UWCubeSat/HS2-CDH-PCB/Simulations/TPS2596xx_Design_Calculator.xlsm

Sheet: Calculation Sheet
TPS2596xx Design Calculation Tool |  |  |  |  |  |  |  |  | Table - 1: Device Comparison Table
 |  |  |  |  |  |  |  |  | Part number | Overvoltage Response | Response to Thermal Shutdown (TSD)
 | Constants Cells |  |  |  |  |  |  |  | TPS259620 | OVC - 3.8 V, 5.7 V, 13.7 V (Pin Selectable) | Latch-off
 | Input/SelectCells |  |  |  |  |  |  |  | TPS259621 | OVC - 3.8 V, 5.7 V, 13.7 V (Pin Selectable) | Auto-retry
 | Calculation Cells |  |  |  |  |  |  |  | TPS259630 | Adjustable OVLO | Latch-off
 | Calculated, but can be over-ridden by user |  |  |  |  |  |  |  | TPS259531 | Adjustable OVLO | Auto-retry
 | Error Cells, Must be Fixed
Parameter | Description | Value | Units | Tolerance | Recommended Value
Select Device | Refer to Table-1 and select based on OverVoltage Clamp/Lockout and Latch-off/Auto-retry requirement | TPS259620
VIN (max) | Maximum Operating input voltage (magnitude) | 12.00 | V
VCLAMP | Desired Over Voltage Clamp | 13.58 | V | 3.5%
UVLO Set Point | Desired Undervoltage Threshold (VIN Rising) | 8.00 | V | 3.0% |  | R_OVCSEL | Short to GND | 400
VUVP | Internal Undervoltage Protection Threshold (VIN Rising) | 2.53 | V | 3.0%
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
