UWCubeSat/HS2-CDH-PCB/(list of files, drawings)

Other design files:
Simulations/Payload Camera Input Spice.ms14
Simulations/Payload Camera Output Spice.ms14
Simulations/Payload Camera Spice.ms14
