UWCubeSat/HS2-CDH-PCB/Payload PCB/hs2-payload-pcb/hs2-payload-pcb.kicad_pcb

## KiCad design Payload PCB/hs2-payload-pcb/hs2-payload-pcb.kicad_pcb (2026-11-13)

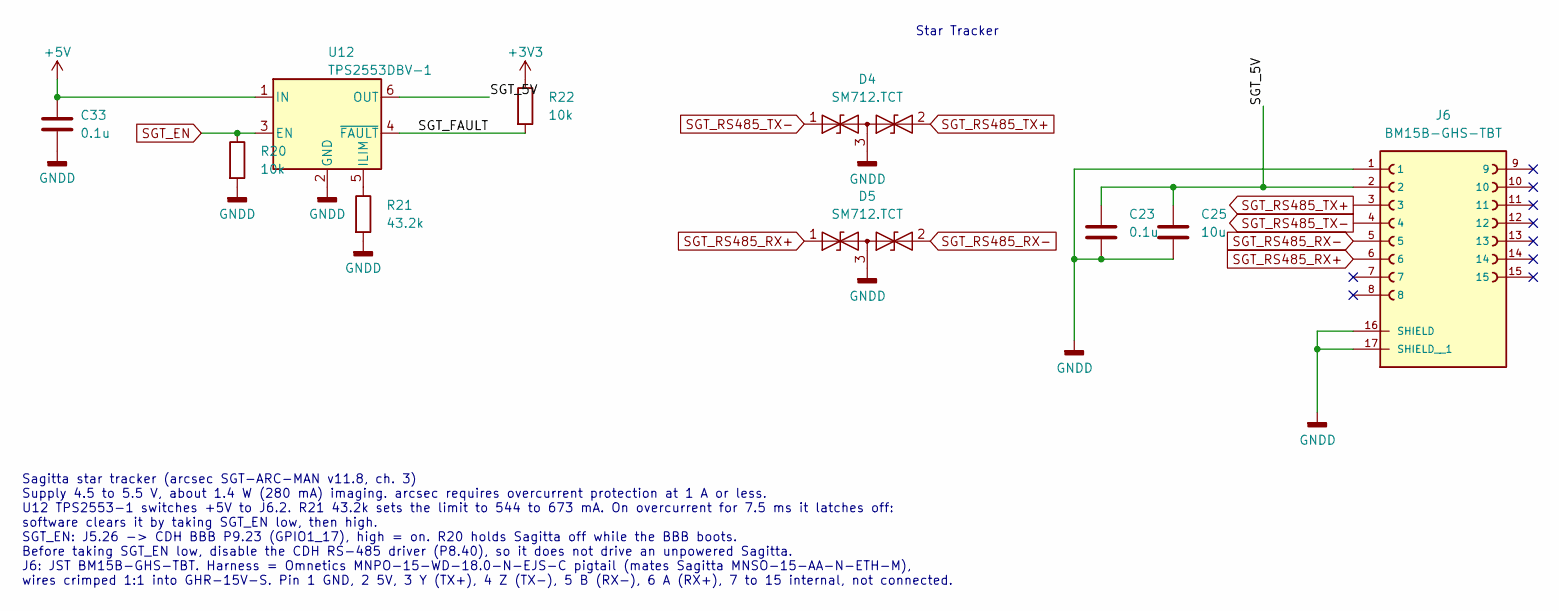
[picture p1: schematic Sagitta.kicad_sch, Star tracker (Sagitta)]

Parts:
C23, C33: 0.1u; C_0603_1608Metric
C25: 10u; C_0603_1608Metric
D4, D5: SM712.TCT; SOT-23; MPN SM712.TCT
J6: BM15B-GHS-TBT; BM15BGHSTBTLFSN; PARTREV B
R20, R22: 10k; R_0603_1608Metric
R21: 43.2k; R_0603_1608Metric
U12: TPS2553DBV-1; SOT-23-6; MPN TPS2553DBVR-1

Connections:
+3V3: R22.1; also elsewhere on the board
+5V: C33.1, U12.1 (IN); also elsewhere on the board
/Sagitta/SGT_5V: C23.1, C25.1, J6.2, U12.6 (OUT)
/Sagitta/SGT_FAULT: R22.2, U12.4 (~FAULT)
GNDD: C23.2, C25.2, C33.2, D4.3 (common), D5.3 (common), J6.1, J6.16 (SHIELD), J6.17 (SHIELD__1), R20.2, R21.2, U12.2 (GND); also elsewhere on the board
unnamed: R21.1, U12.5 (ILIM)
SGT_EN: R20.1, U12.3 (EN); also elsewhere on the board
SGT_RS485_RX+: D5.1 (A1), J6.6; also elsewhere on the board
SGT_RS485_RX-: D5.2 (A2), J6.5; also elsewhere on the board
SGT_RS485_TX+: D4.2 (A2), J6.3; also elsewhere on the board
SGT_RS485_TX-: D4.1 (A1), J6.4; also elsewhere on the board

Notes on the sheet:
Star Tracker
Sagitta star tracker (arcsec SGT-ARC-MAN v11.8, ch. 3) Supply 4.5 to 5.5 V, about 1.4 W (280 mA) imaging. arcsec requires overcurrent protection at 1 A or less. U12 TPS2553-1 switches +5V to J6.2. R21 43.2k sets the limit to 544 to 673 mA. On overcurrent for 7.5 ms it latches off: software clears i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

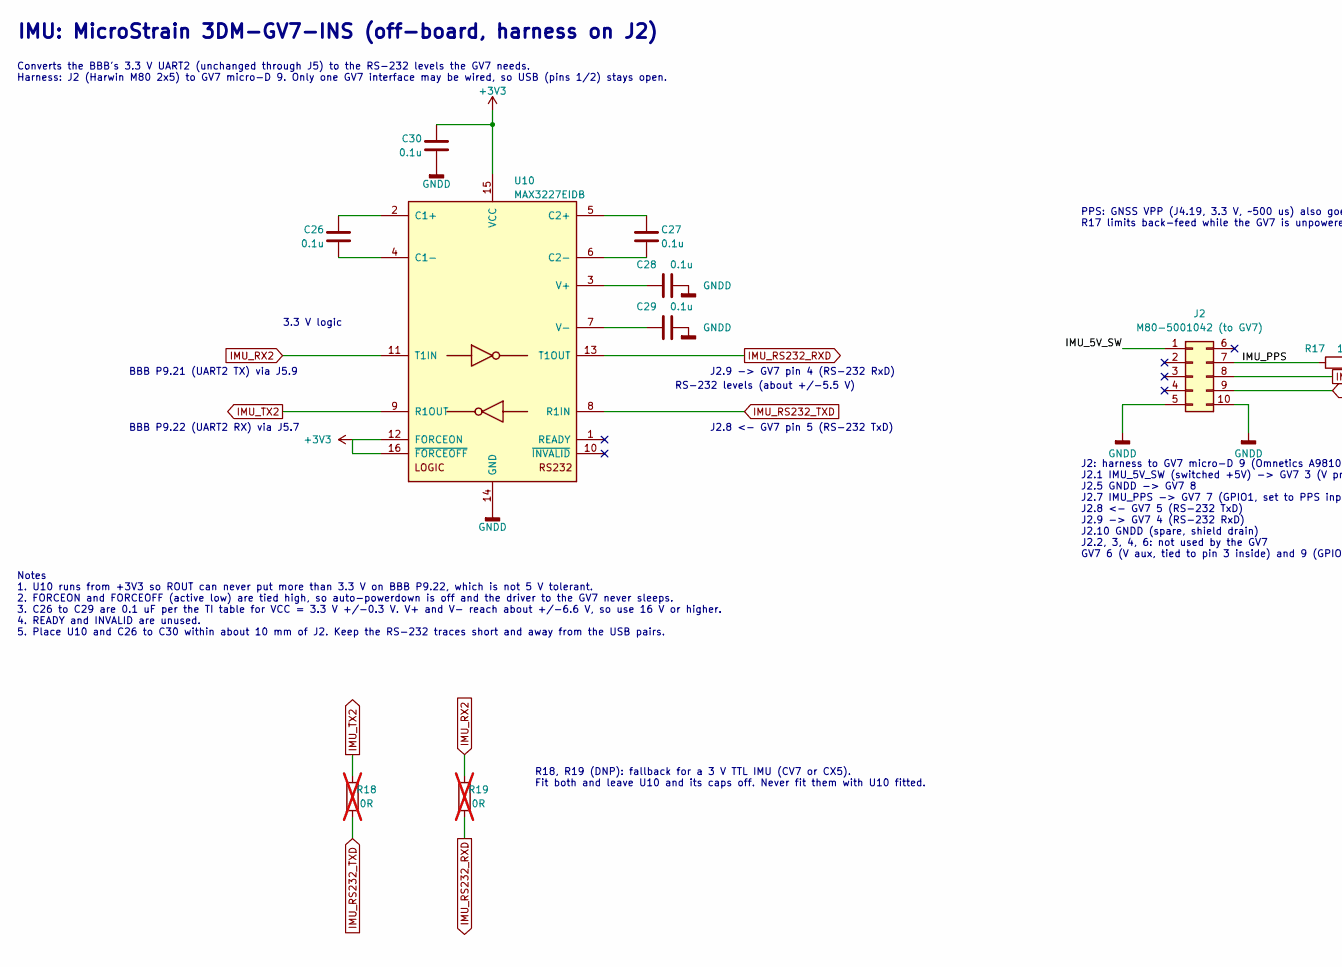
[picture p2: schematic IMU.kicad_sch, part in row 1, column 1]

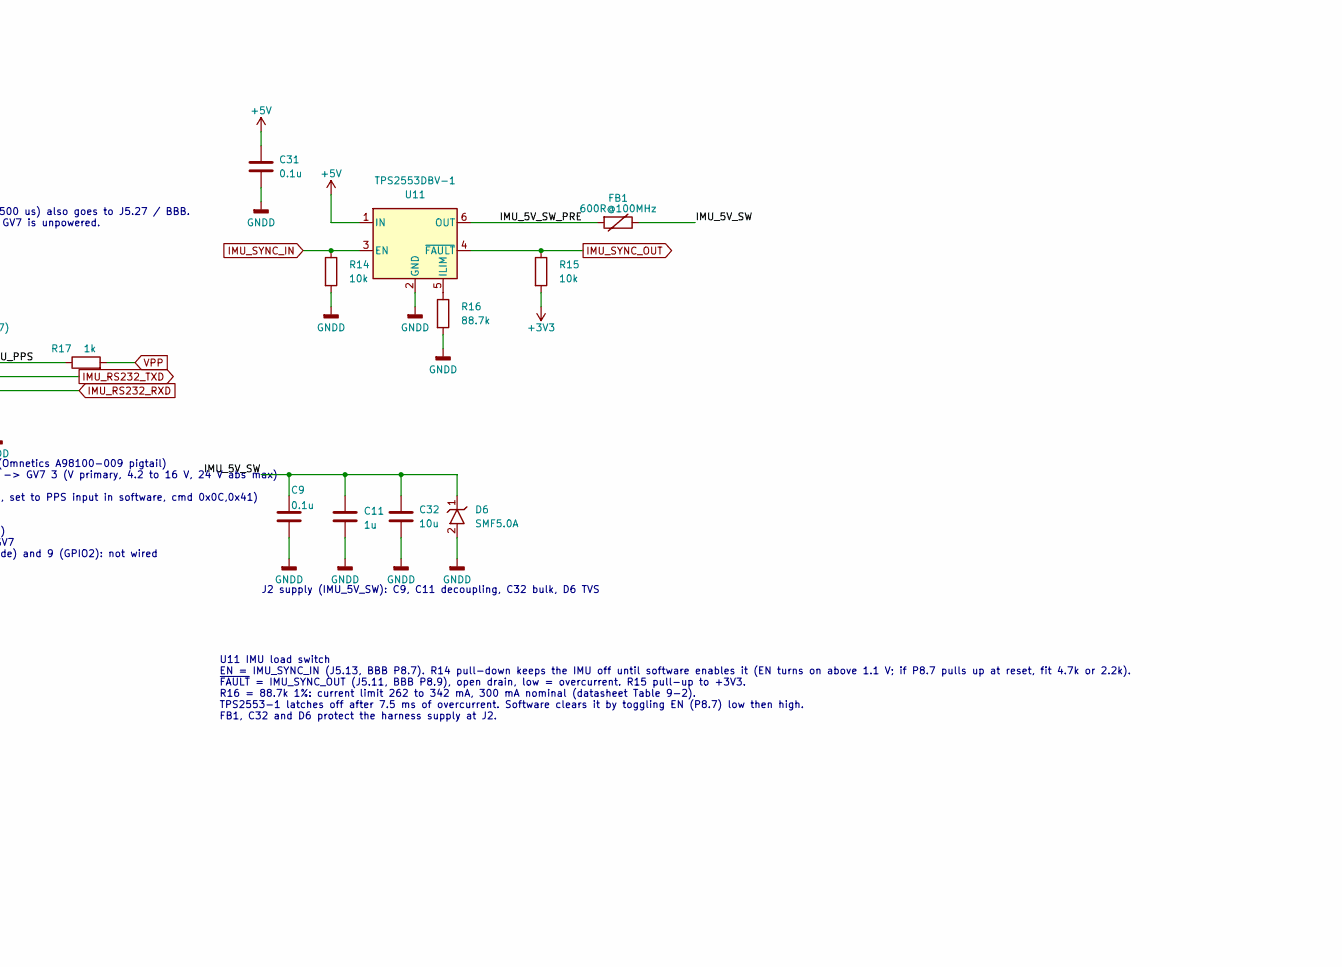
[picture p3: schematic IMU.kicad_sch, part in row 1, column 2]

Parts:
C9, C26, C27, C28, C29, C30, C31: 0.1u; C_0603_1608Metric
C11: 1u; C_0603_1608Metric
C32: 10u; C_0805_2012Metric
D6: SMF5.0A; D_SMF; MPN SMF5.0A
FB1: 600R@100MHz; L_0805_2012Metric
J2: M80-5001042 (to GV7); Harwin-M80-5001042-0-0-MFG
R14, R15: 10k; R_0603_1608Metric
R16: 88.7k; R_0603_1608Metric
R17: 1k; R_0603_1608Metric
R18, R19: 0R; R_0402_1005Metric; not fitted
U10: MAX3227EIDB; SSOP-16_5.3x6.2mm_P0.65mm; MPN MAX3227EIDBR
U11: TPS2553DBV-1; SOT-23-6; MPN TPS2553DBVR-1

Connections:
+3V3: C30.1, R15.2, U10.12 (FORCEON), U10.15 (VCC), U10.16 (~FORCEOFF); also elsewhere on the board
+5V: C31.1, U11.1 (IN); also elsewhere on the board
/IMU/IMU_5V_SW: C9.1, C11.1, C32.1, D6.1 (K), FB1.2, J2.1
/IMU/IMU_5V_SW_PRE: FB1.1, U11.6 (OUT)
/IMU/IMU_PPS: J2.7, R17.1
GNDD: C9.2, C11.2, C28.2, C29.2, C30.2, C31.2, C32.2, D6.2 (A), J2.5, J2.10, R14.2, R16.2, U10.14 (GND), U11.2 (GND); also elsewhere on the board
IMU_RS232_RXD: J2.9, R19.2, U10.13 (T1OUT)
IMU_RS232_TXD: J2.8, R18.2, U10.8 (R1IN)
IMU_RX2: R19.1, U10.11 (T1IN); also elsewhere on the board
IMU_SYNC_IN: R14.1, U11.3 (EN); also elsewhere on the board
IMU_SYNC_OUT: R15.1, U11.4 (~FAULT); also elsewhere on the board
IMU_TX2: R18.1, U10.9 (R1OUT); also elsewhere on the board
unnamed: C26.1, U10.2 (C1+)
unnamed: C26.2, U10.4 (C1-)
unnamed: C27.1, U10.5 (C2+)
unnamed: C27.2, U10.6 (C2-)
unnamed: C28.1, U10.3 (V+)
unnamed: C29.1, U10.7 (V-)
unnamed: R16.1, U11.5 (ILIM)
VPP: R17.2; also elsewhere on the board

Notes on the sheet:
BBB P9.22 (UART2 RX) via J5.7
U11 IMU load switch EN = IMU_SYNC_IN (J5.13, BBB P8.7). R14 pull-down keeps the IMU off until software enables it (EN turns on above 1.1 V; if P8.7 pulls up at reset, fit 4.7k or 2.2k). ~{FAULT} = IMU_SYNC_OUT (J5.11, BBB P8.9), open drain, low = overcurrent. R15 pull-up to +3V3. R16 = 88.7k 1%: cu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
3.3 V logic
PPS: GNSS VPP (J4.19, 3.3 V, ~500 us) also goes to J5.27 / BBB. R17 limits back-feed while the GV7 is unpowered.
IMU: MicroStrain 3DM-GV7-INS (off-board, harness on J2)
Converts the BBB's 3.3 V UART2 (unchanged through J5) to the RS-232 levels the GV7 needs. Harness: J2 (Harwin M80 2x5) to GV7 micro-D 9. Only one GV7 interface may be wired, so USB (pins 1/2) stays open.
J2.8 <- GV7 pin 5 (RS-232 TxD)
Notes 1. U10 runs from +3V3 so ROUT can never put more than 3.3 V on BBB P9.22, which is not 5 V tolerant. 2. FORCEON and FORCEOFF (active low) are tied high, so auto-powerdown is off and the driver to the GV7 never sleeps. 3. C26 to C29 are 0.1 uF per the TI table for VCC = 3.3 V +/-0.3 V. V+ and 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
RS-232 levels (about +/-5.5 V)
BBB P9.21 (UART2 TX) via J5.9
J2 supply (IMU_5V_SW): C9, C11 decoupling, C32 bulk, D6 TVS
J2: harness to GV7 micro-D 9 (Omnetics A98100-009 pigtail) J2.1 IMU_5V_SW (switched +5V) -> GV7 3 (V primary, 4.2 to 16 V, 24 V abs max) J2.5 GNDD -> GV7 8 J2.7 IMU_PPS -> GV7 7 (GPIO1, set to PPS input in software, cmd 0x0C,0x41) J2.8 <- GV7 5 (RS-232 TxD) J2.9 -> GV7 4 (RS-232 RxD) J2.10 GNDD (sp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
R18, R19 (DNP): fallback for a 3 V TTL IMU (CV7 or CX5). Fit both and leave U10 and its caps off. Never fit them with U10 fitted.
J2.9 -> GV7 pin 4 (RS-232 RxD)

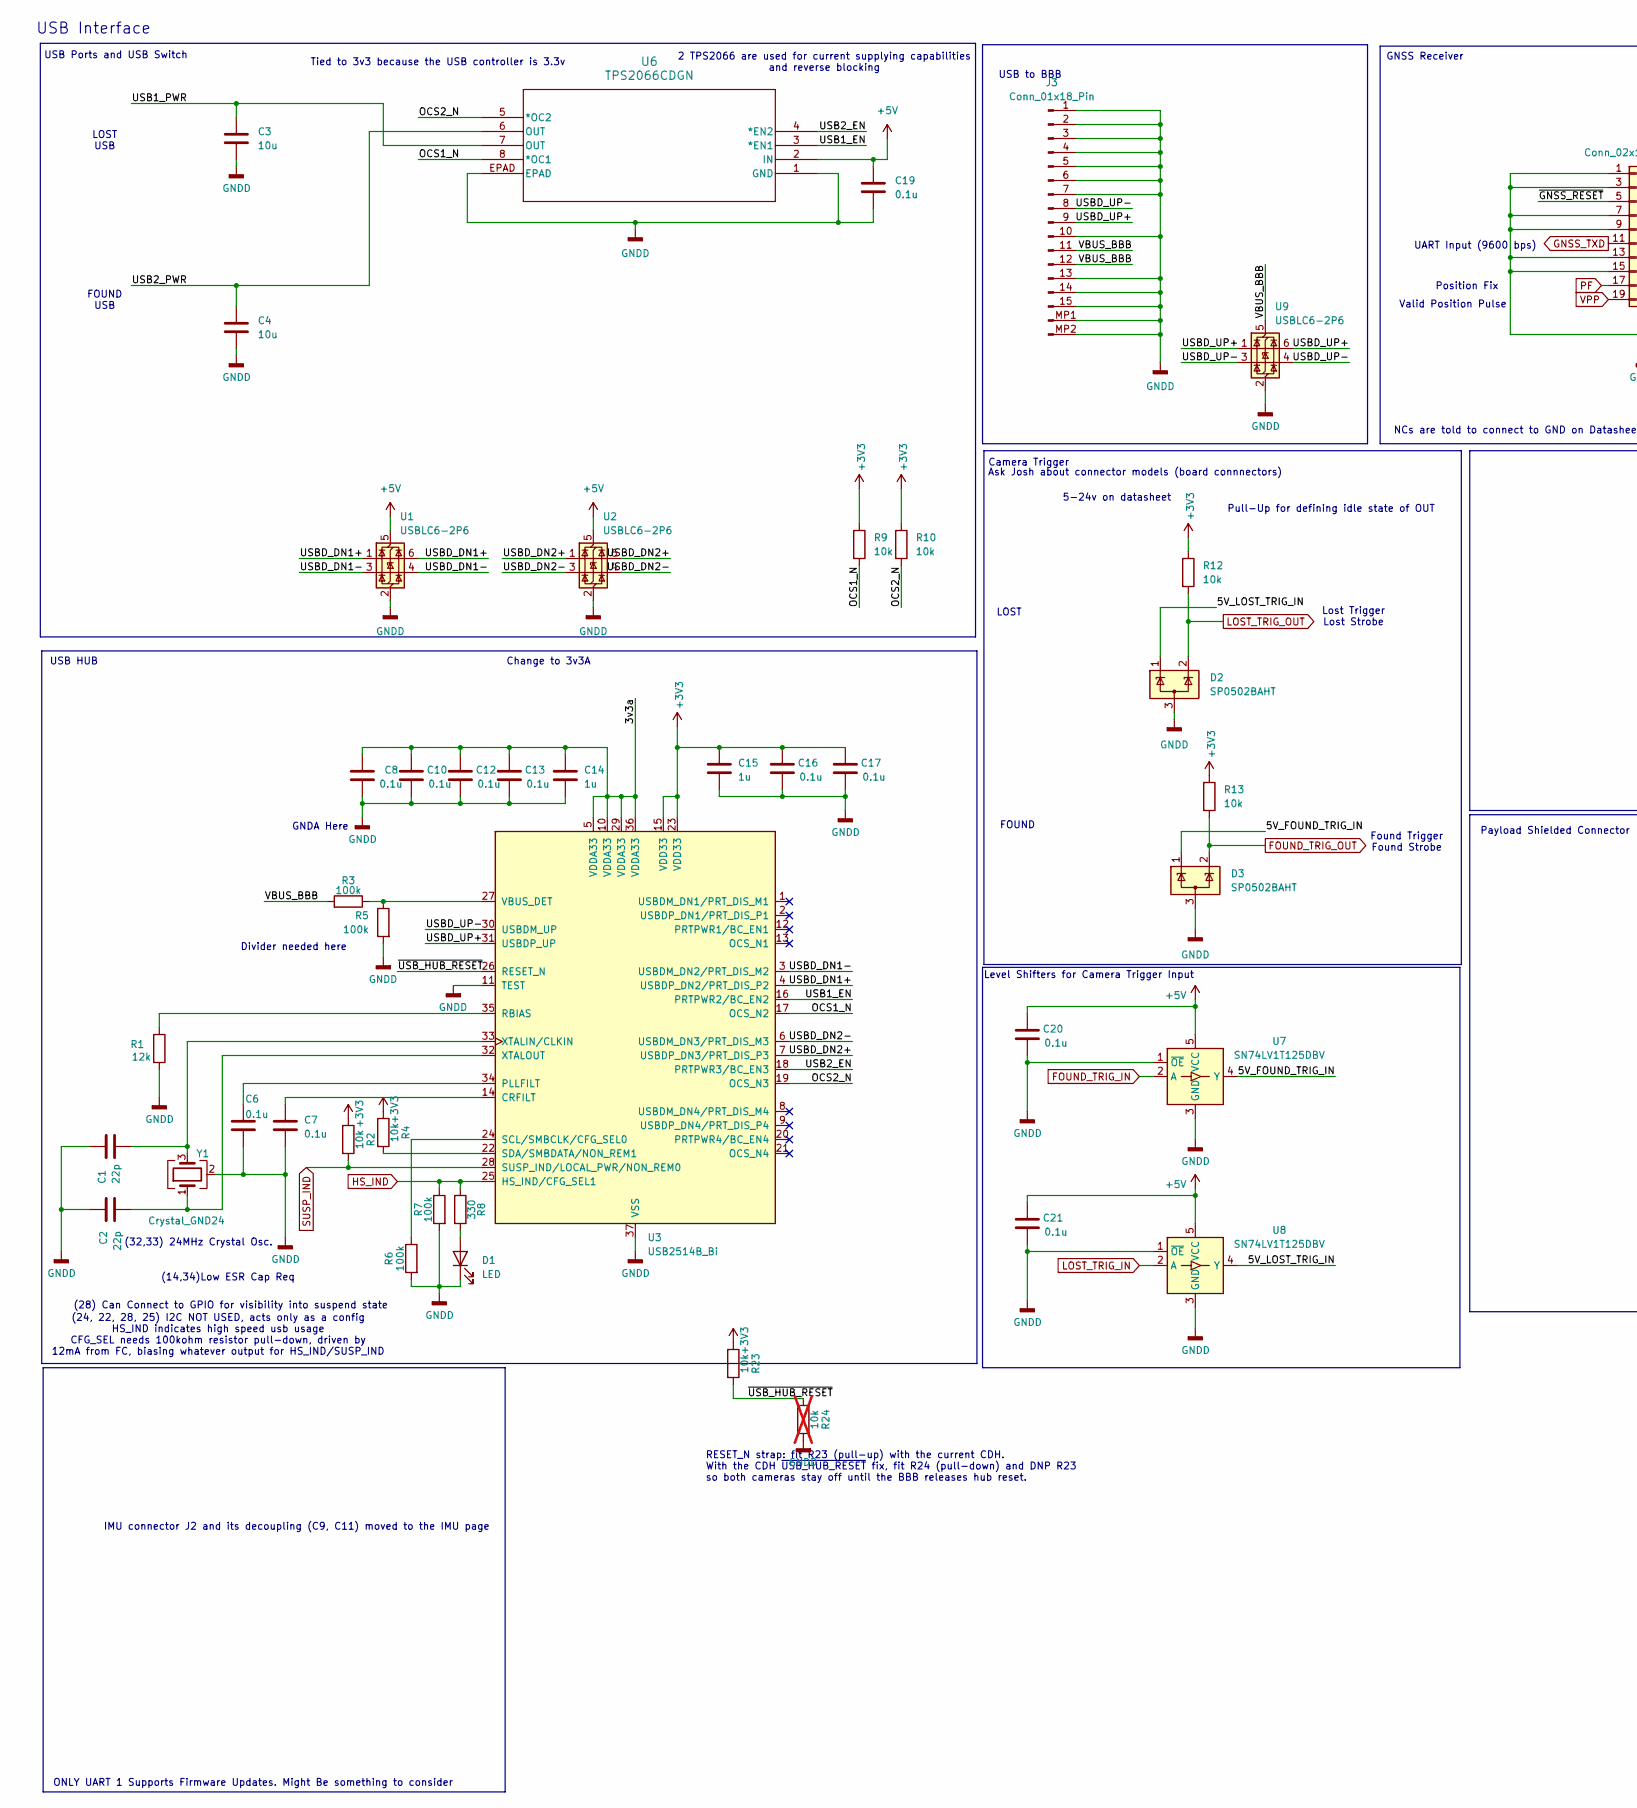
[picture p4: schematic Payload_USB.kicad_sch, part in row 1, column 1]

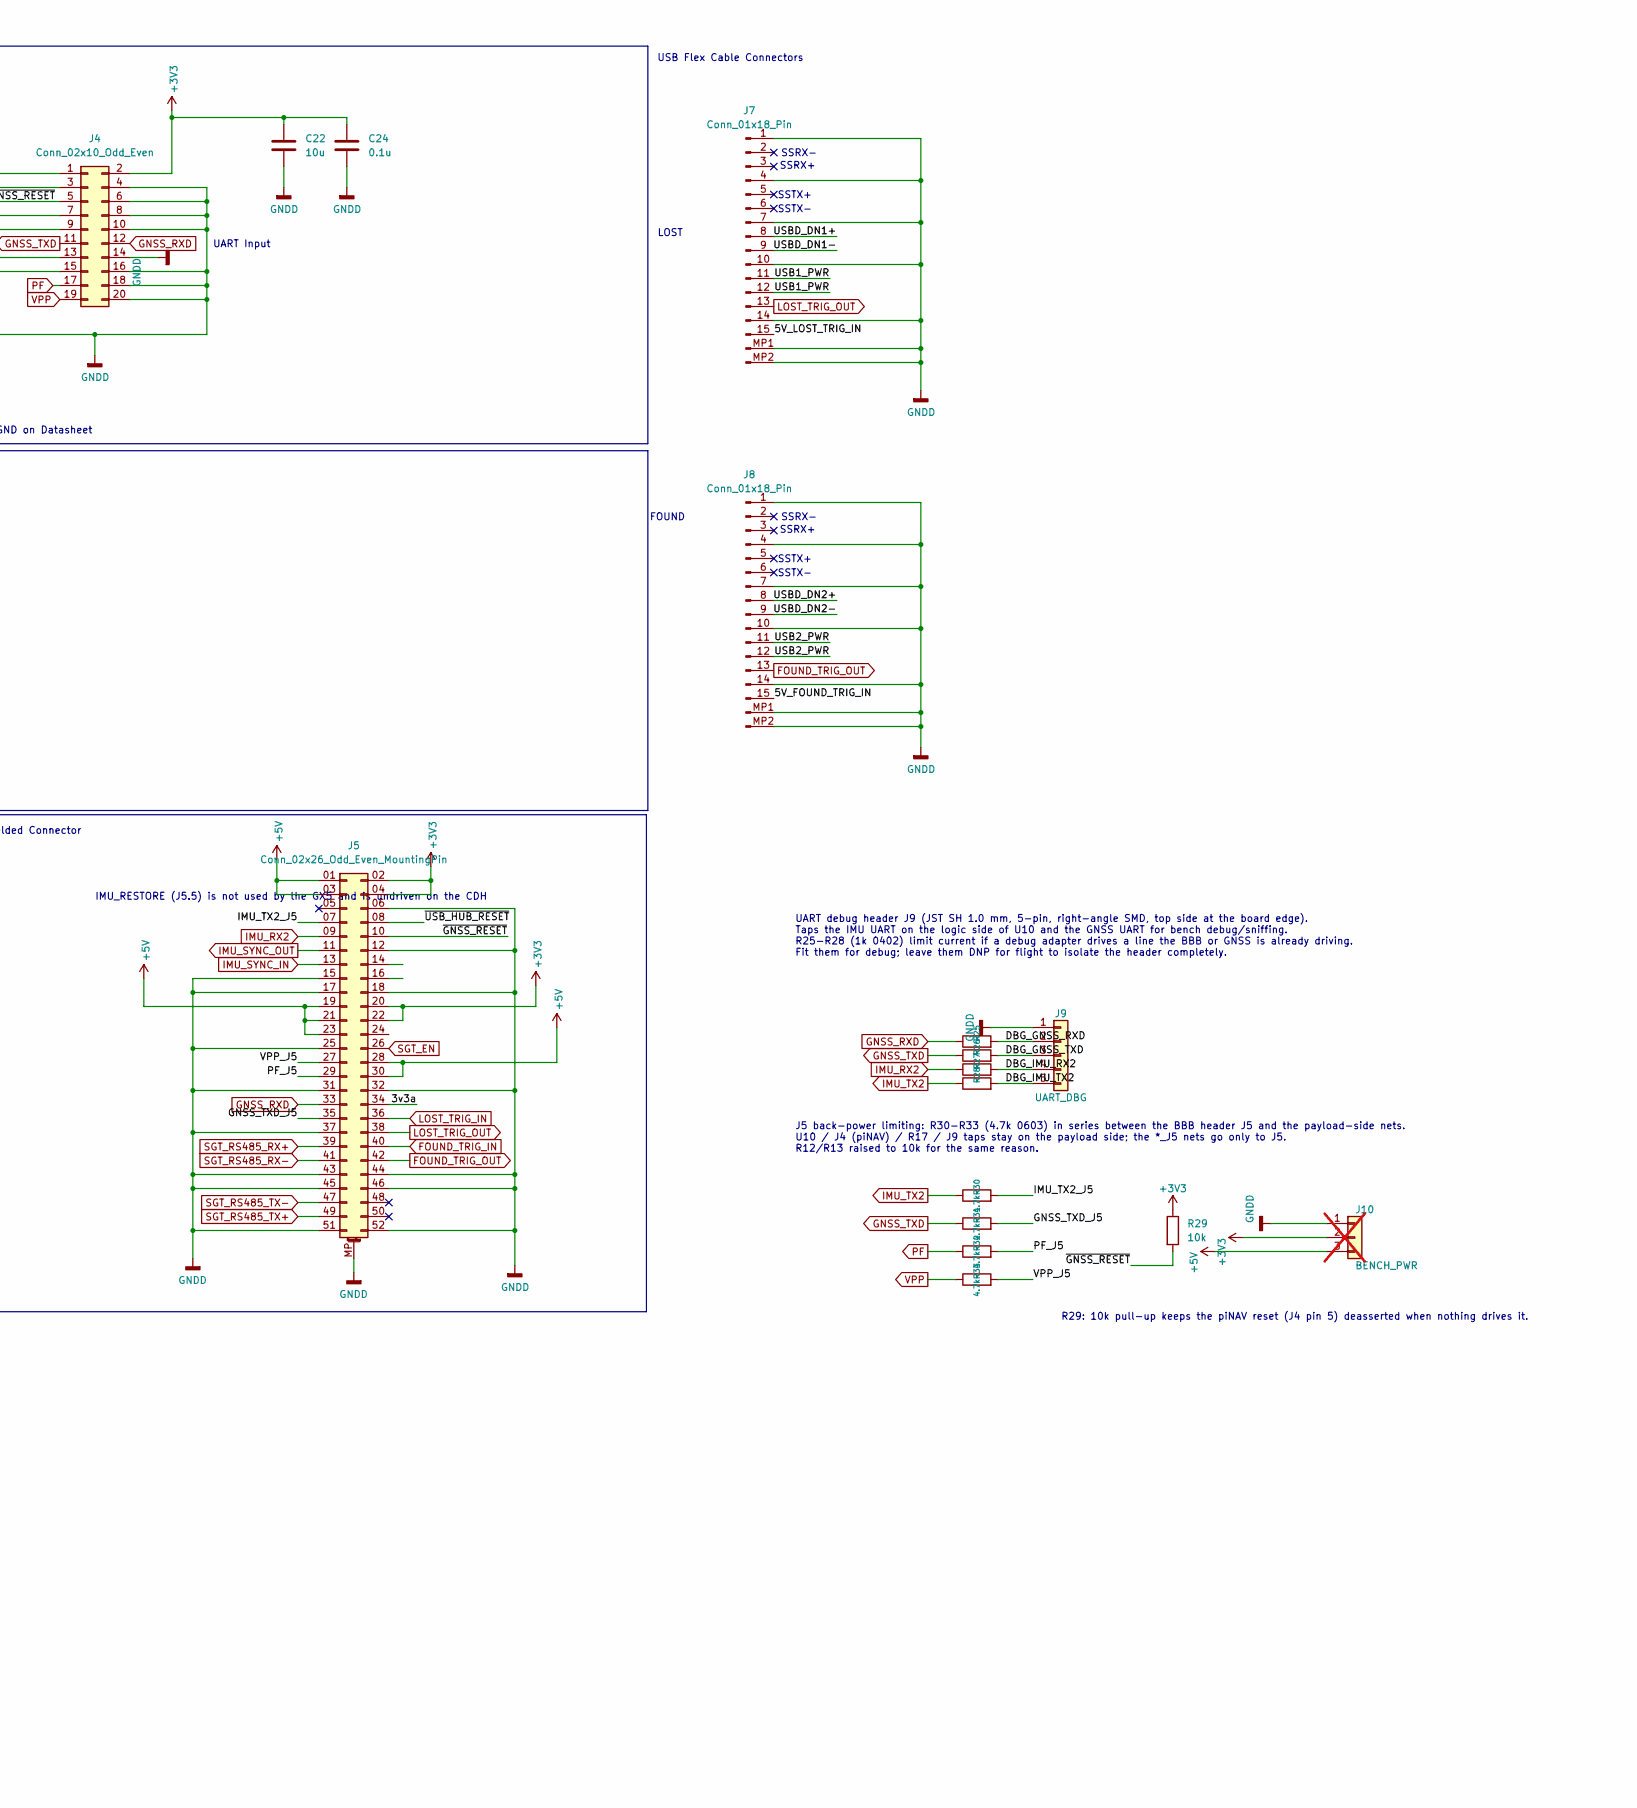
[picture p5: schematic Payload_USB.kicad_sch, part in row 1, column 2]

Parts:
C1, C2: 22p; C_0603_1608Metric
C3, C4, C22: 10u; C_0603_1608Metric
C6, C7, C8, C10, C12, C13, C16, C17, C19, C20, C21, C24: 0.1u; C_0603_1608Metric
C14, C15: 1u; C_0603_1608Metric
D1: LED; LED_0603_1608Metric
D2, D3: SP0502BAHT; SOT-23
J3, J7, J8: Conn_01x18_Pin; Molex 502231-1500
J4: Conn_02x10_Odd_Even; PinHeader_2x10_P2.00mm_Vertical
J5: Conn_02x26_Odd_Even_MountingPin; SAMTEC_ASP-129646-01
J9: UART_DBG; JST_SH_SM05B-SRSS-TB_1x05-1MP_P1.00mm_Horizontal
J10: BENCH_PWR; PinHeader_1x03_P2.54mm_Horizontal; not fitted
R1: 12k; R_0603_1608Metric
R2, R4, R9, R10, R12, R13, R23, R29: 10k; R_0603_1608Metric
R3, R5, R6, R7: 100k; R_0603_1608Metric
R8: 330; R_0603_1608Metric
R24: 10k; R_0603_1608Metric; not fitted
R25, R26, R27, R28: 1k; R_0603_1608Metric
R30, R31, R32, R33: 4.7k; R_0603_1608Metric
U1, U2, U9: USBLC6-2P6; SOT-666
U3: USB2514B_Bi; QFN-36-1EP_6x6mm_P0.5mm_EP3.7x3.7mm
U6: TPS2066CDGN; DGN8_1P89x1P57_TEX
U7, U8: SN74LV1T125DBV; SOT-23-5
Y1: Crystal_GND24; Crystal_SMD_Abracon_ABM8G-4Pin_3.2x2.5mm

Connections:
+3V3: C15.1, C16.1, C17.1, C22.1, C24.1, J4.2, J5.02 (Pin_2), J5.04 (Pin_4), J5.20, J5.22, J10.2, R2.1, R4.1, R9.1, R10.1, R12.1, R13.1, R23.1, R29.1, U3.15 (VDD33), U3.23 (VDD33); also elsewhere on the board
+5V: C19.1, C20.1, C21.1, J5.01 (Pin_1), J5.03 (Pin_3), J5.19, J5.21, J5.23, J5.28, J5.30, J10.3, U1.5 (VBUS), U2.5 (VBUS), U6.2 (IN), U7.5 (VCC), U8.5 (VCC); also elsewhere on the board
/Payload_USB/3v3a: C8.1, C10.1, C12.1, C13.1, C14.1, J5.34, U3.5 (VDDA33), U3.10 (VDDA33), U3.29 (VDDA33), U3.36 (VDDA33)
/Payload_USB/5V_FOUND_TRIG_IN: D3.1 (K), J8.15, U7.4 (Y)
/Payload_USB/5V_LOST_TRIG_IN: D2.1 (K), J7.15, U8.4 (Y)
/Payload_USB/DBG_GNSS_RXD: J9.2, R25.2
/Payload_USB/DBG_GNSS_TXD: J9.3, R26.2
/Payload_USB/DBG_IMU_RX2: J9.4, R27.2
/Payload_USB/DBG_IMU_TX2: J9.5, R28.2
/Payload_USB/GNSS_TXD_J5: J5.35, R31.2
/Payload_USB/IMU_TX2_J5: J5.07 (Pin_7), R30.2
/Payload_USB/OCS1_N: R9.2, U3.17 (OCS_N2), U6.8 (*OC1)
/Payload_USB/OCS2_N: R10.2, U3.19 (OCS_N3), U6.5 (*OC2)
/Payload_USB/PF_J5: J5.29, R32.2
/Payload_USB/USB1_EN: U3.16 (PRTPWR2/BC_EN2), U6.3 (*EN1)
/Payload_USB/USB1_PWR: C3.1, J7.11, J7.12, U6.7 (OUT)
/Payload_USB/USB2_EN: U3.18 (PRTPWR3/BC_EN3), U6.4 (*EN2)
/Payload_USB/USB2_PWR: C4.1, J8.11, J8.12, U6.6 (OUT)
/Payload_USB/USBD_DN1+: J7.8, U1.1 (I/O1), U1.6 (I/O1), U3.4 (USBDP_DN2/PRT_DIS_P2)
/Payload_USB/USBD_DN1-: J7.9, U1.3 (I/O2), U1.4 (I/O2), U3.3 (USBDM_DN2/PRT_DIS_M2)
/Payload_USB/USBD_DN2+: J8.8, U2.1 (I/O1), U2.6 (I/O1), U3.7 (USBDP_DN3/PRT_DIS_P3)
/Payload_USB/USBD_DN2-: J8.9, U2.3 (I/O2), U2.4 (I/O2), U3.6 (USBDM_DN3/PRT_DIS_M3)
/Payload_USB/USBD_UP+: J3.9, U3.31 (USBDP_UP), U9.1 (I/O1), U9.6 (I/O1)
/Payload_USB/USBD_UP-: J3.8, U3.30 (USBDM_UP), U9.3 (I/O2), U9.4 (I/O2)
/Payload_USB/VBUS_BBB: J3.11, J3.12, R3.2, U9.5 (VBUS)
/Payload_USB/VPP_J5: J5.27, R33.2
/Payload_USB/~GNSS_RESET: J4.5, J5.10, R29.2
/Payload_USB/~USB_HUB_RESET: J5.08 (Pin_8), R23.2, R24.1, U3.26 (RESET_N)
FOUND_TRIG_IN: J5.40, U7.2 (A)
FOUND_TRIG_OUT: D3.2 (K), J5.42, J8.13, R13.2
GNDD: C1.1, C2.1, C3.2, C4.2, C6.2, C7.2, C8.2, C10.2, C12.2, C13.2, C14.2, C15.2, C16.2, C17.2, C19.2, C20.2, C21.2, C22.2, C24.2, D1.1 (K), D2.3 (A), D3.3 (A), J3.1, J3.2, J3.3, J3.4, J3.5, J3.6, J3.7, J3.10, J3.13, J3.14, J3.15, J3.MP1, J3.MP2, J4.1, J4.3, J4.4, J4.6, J4.7, J4.8, J4.9, J4.10, J4.13, J4.14, J4.15, J4.16, J4.18, J4.20, J5.06 (Pin_6), J5.12, J5.15, J5.17, J5.18, J5.25, J5.31, J5.32, J5.37, J5.43, J5.44, J5.45, J5.46, J5.51, J5.52, J5.MP (MountPin), J7.1, J7.4, J7.7, J7.10, J7.14, J7.MP1, J7.MP2, J8.1, J8.4, J8.7, J8.10, J8.14, J8.MP1, J8.MP2, J9.1, J10.1, R1.2, R5.2, R6.2, R7.2, R24.2, U1.2 (GND), U2.2 (GND), U3.11 (TEST), U3.37 (VSS), U6.1 (GND), U6.EPAD, U7.1 (~OE), U7.3 (GND), U8.1 (~OE), U8.3 (GND), U9.2 (GND), Y1.2 (G), Y1.4 (G); also elsewhere on the board
GNSS_RXD: J4.12, J5.33, R25.1
GNSS_TXD: J4.11, R26.1, R31.1
HS_IND: R7.1, R8.1, U3.25 (HS_IND/CFG_SEL1)
IMU_RX2: J5.09 (Pin_9), R27.1; also elsewhere on the board
IMU_SYNC_IN: J5.13; also elsewhere on the board
IMU_SYNC_OUT: J5.11; also elsewhere on the board
IMU_TX2: R28.1, R30.1; also elsewhere on the board
LOST_TRIG_IN: J5.36, U8.2 (A)
LOST_TRIG_OUT: D2.2 (K), J5.38, J7.13, R12.2
unnamed: D1.2 (A), R8.2
unnamed: C7.1, U3.14 (CRFILT)
unnamed: C6.1, U3.34 (PLLFILT)
unnamed: R1.1, U3.35 (RBIAS)
unnamed: R6.1, U3.24 (SCL/SMBCLK/CFG_SEL0)
unnamed: R4.2, U3.22 (SDA/SMBDATA/NON_REM1)
unnamed: R3.1, R5.1, U3.27 (VBUS_DET)
unnamed: C1.2, U3.33 (XTALIN/CLKIN), Y1.3
unnamed: C2.2, U3.32 (XTALOUT), Y1.1
PF: J4.17, R32.1
SGT_EN: J5.26; also elsewhere on the board
SGT_RS485_RX+: J5.39; also elsewhere on the board
SGT_RS485_RX-: J5.41; also elsewhere on the board
SGT_RS485_TX+: J5.49; also elsewhere on the board
SGT_RS485_TX-: J5.47; also elsewhere on the board
SUSP_IND: R2.2, U3.28 (SUSP_IND/LOCAL_PWR/NON_REM0)
VPP: J4.19, R33.1; also elsewhere on the board

Notes on the sheet:
USB Flex Cable Connectors
LOST USB
SSRX-
Level Shifters for Camera Trigger Input
SSTX-
Camera Trigger
GNDA Here
Change to 3v3A
FOUND USB
Divider needed here
(32,33) 24MHz Crystal Osc.
UART Input
Tied to 3v3 because the USB controller is 3.3v
NCs are told to connect to GND on Datasheet
LOST
SSTX+
ONLY UART 1 Supports Firmware Updates. Might Be something to consider
IMU connector J2 and its decoupling (C9, C11) moved to the IMU page
Pull-Up for defining idle state of OUT
IMU_RESTORE (J5.5) is not used by the GX5 and is undriven on the CDH
Found Trigger Found Strobe
SSRX+
GNSS Receiver
Payload Shielded Connector
(28) Can Connect to GPIO for visibility into suspend state
USB Ports and USB Switch
Position Fix
R29: 10k pull-up keeps the piNAV reset (J4 pin 5) deasserted when nothing drives it.
Ask Josh about connector models (board connnectors)
UART debug header J9 (JST SH 1.0 mm, 5-pin, right-angle SMD, top side at the board edge). Taps the IMU UART on the logic side of U10 and the GNSS UART for bench debug/sniffing. R25-R28 (1k 0402) limit current if a debug adapter drives a line the BBB or GNSS is already driving. Fit them for debug; l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
(24, 22, 28, 25) I2C NOT USED, acts only as a config HS_IND indicates high speed usb usage CFG_SEL needs 100kohm resistor pull-down, driven by 12mA from FC, biasing whatever output for HS_IND/SUSP_IND
Lost Trigger Lost Strobe
FOUND
USB HUB
J5 back-power limiting: R30-R33 (4.7k 0603) in series between the BBB header J5 and the payload-side nets. U10 / J4 (piNAV) / R17 / J9 taps stay on the payload side; the *_J5 nets go only to J5. R12/R13 raised to 10k for the same reason.
Valid Position Pulse
5-24v on datasheet
USB Interface
LOST
USB to BBB
RESET_N strap: fit R23 (pull-up) with the current CDH. With the CDH ~{USB_HUB_RESET} fix, fit R24 (pull-down) and DNP R23 so both cameras stay off until the BBB releases hub reset.
2 TPS2066 are used for current supplying capabilities and reverse blocking
UART Input (9600 bps)
(14,34)Low ESR Cap Req

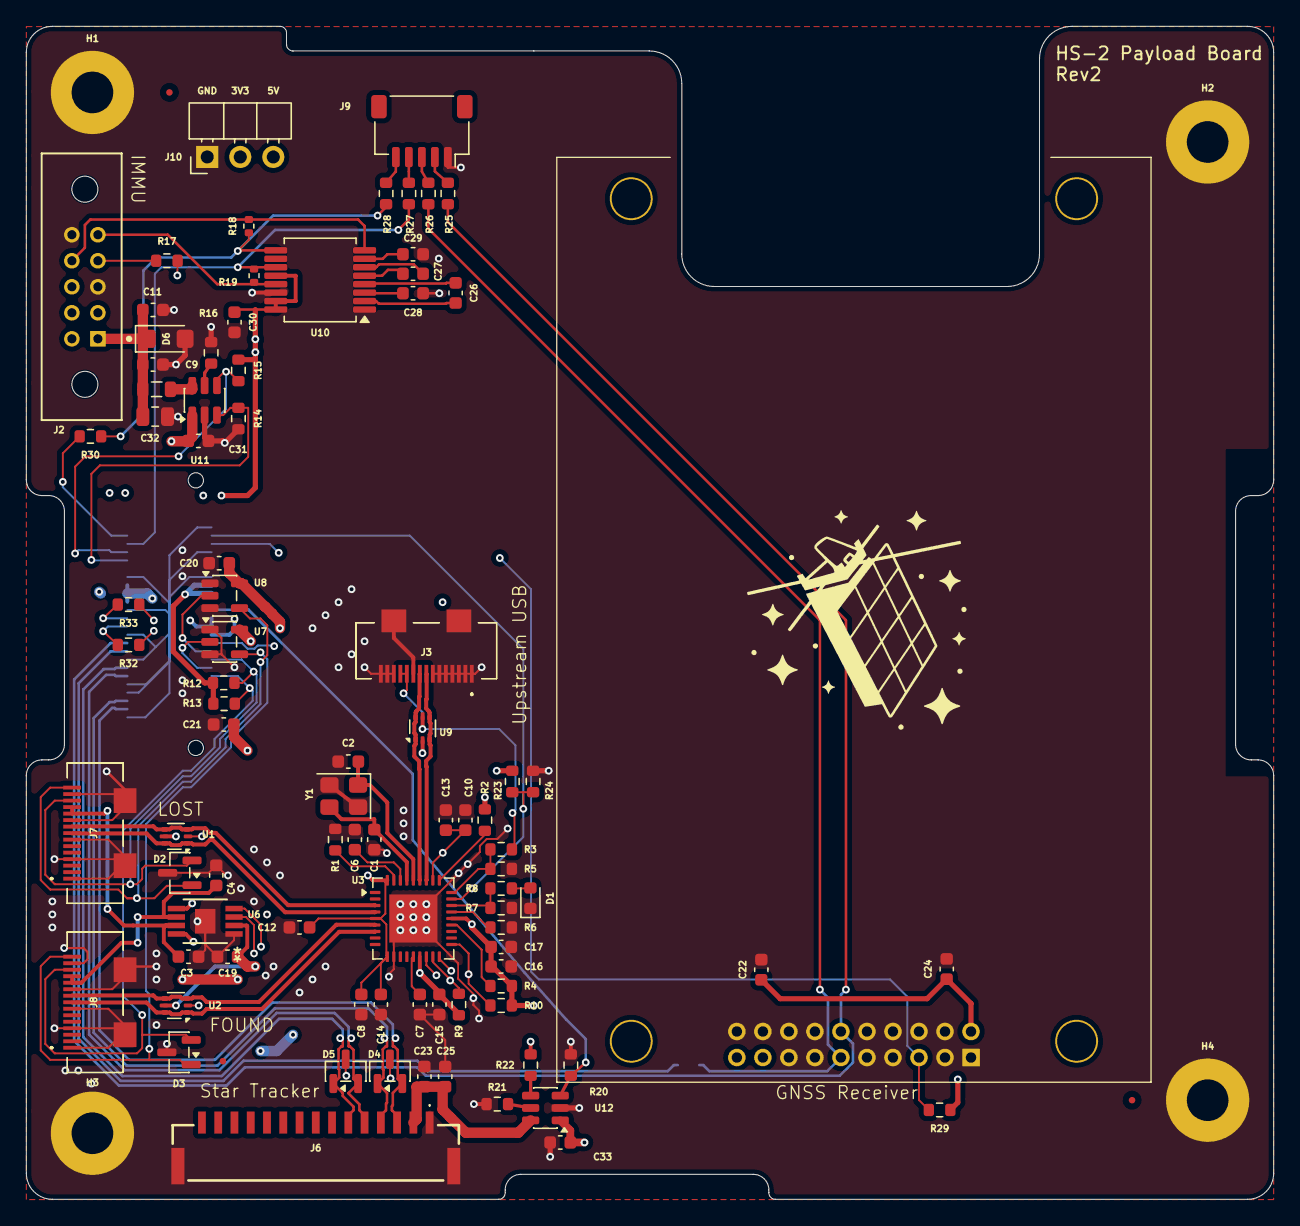
[picture p6: board hs2-payload-pcb.kicad_pcb from above]

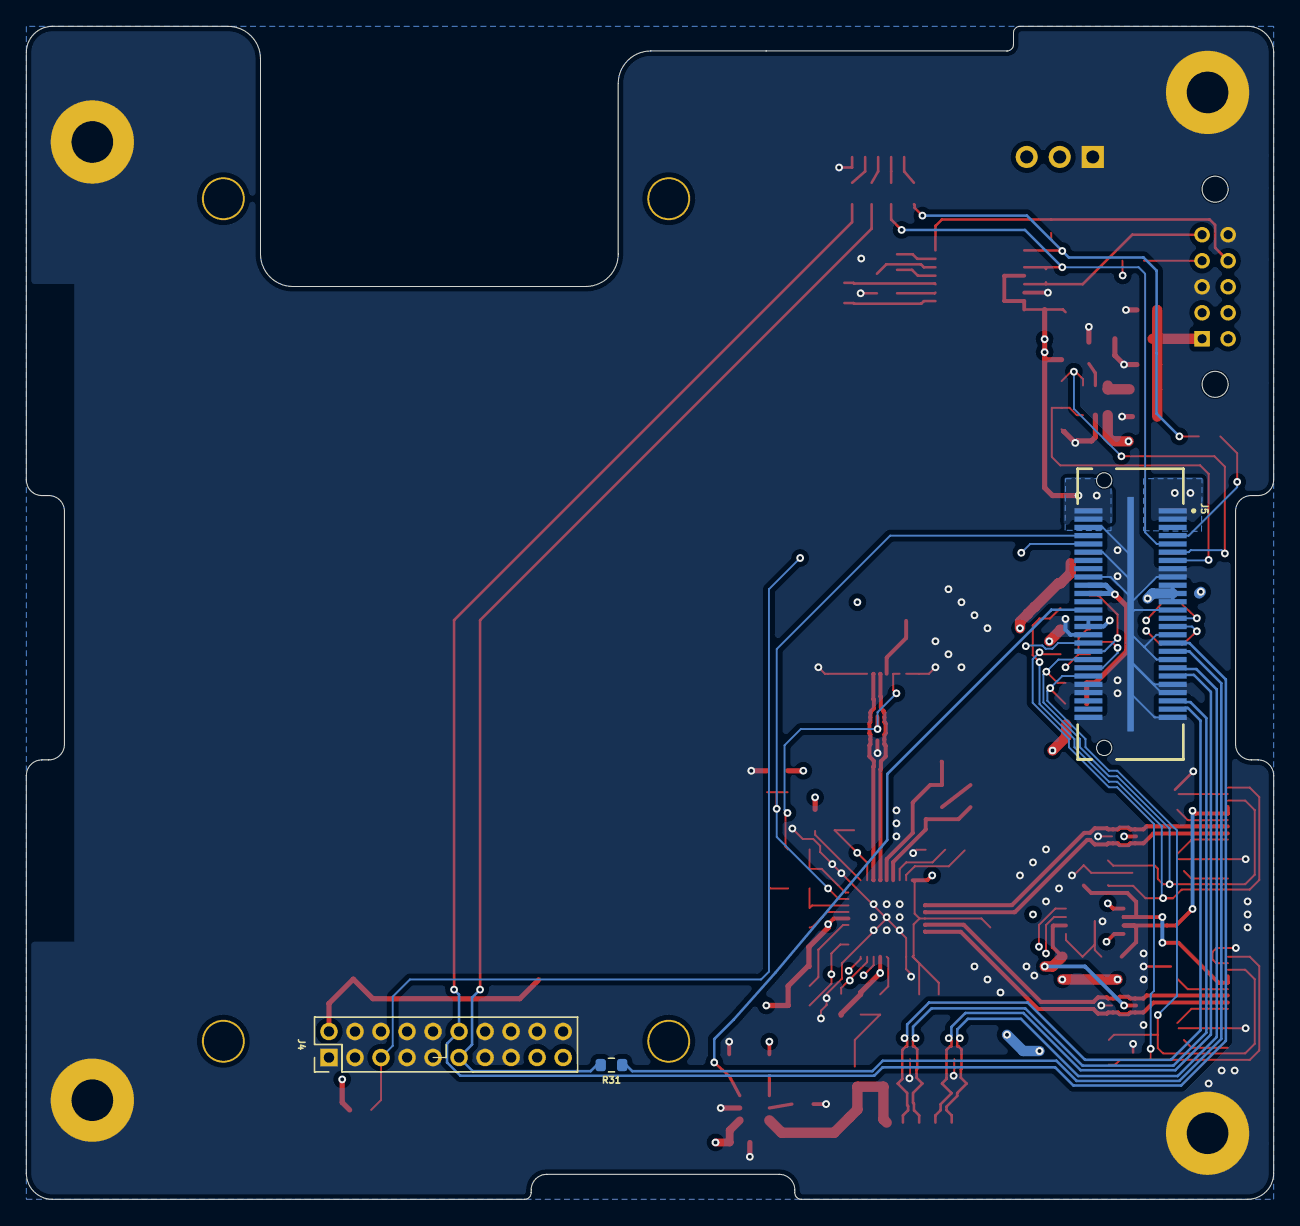
[picture p7: board hs2-payload-pcb.kicad_pcb from below]

Board: 4 copper layers, 95.9 x 90.2 mm, 94 parts (3 on the bottom side), 72 nets.

Other parts of the board:
H1, H2, H3, H4: MountingHole_Pad; MountingHole_3.2mm_M3_Pad

Their connections:
GNDD: H1.1 (1_1), H2.1 (1_1), H3.1 (1_1), H4.1 (1_1); also elsewhere on the board
