UWCubeSat/HS2-CDH-PCB/hs2-cdh-pcb.kicad_pcb

## KiCad design hs2-cdh-pcb.kicad_pcb (2026-08-28)

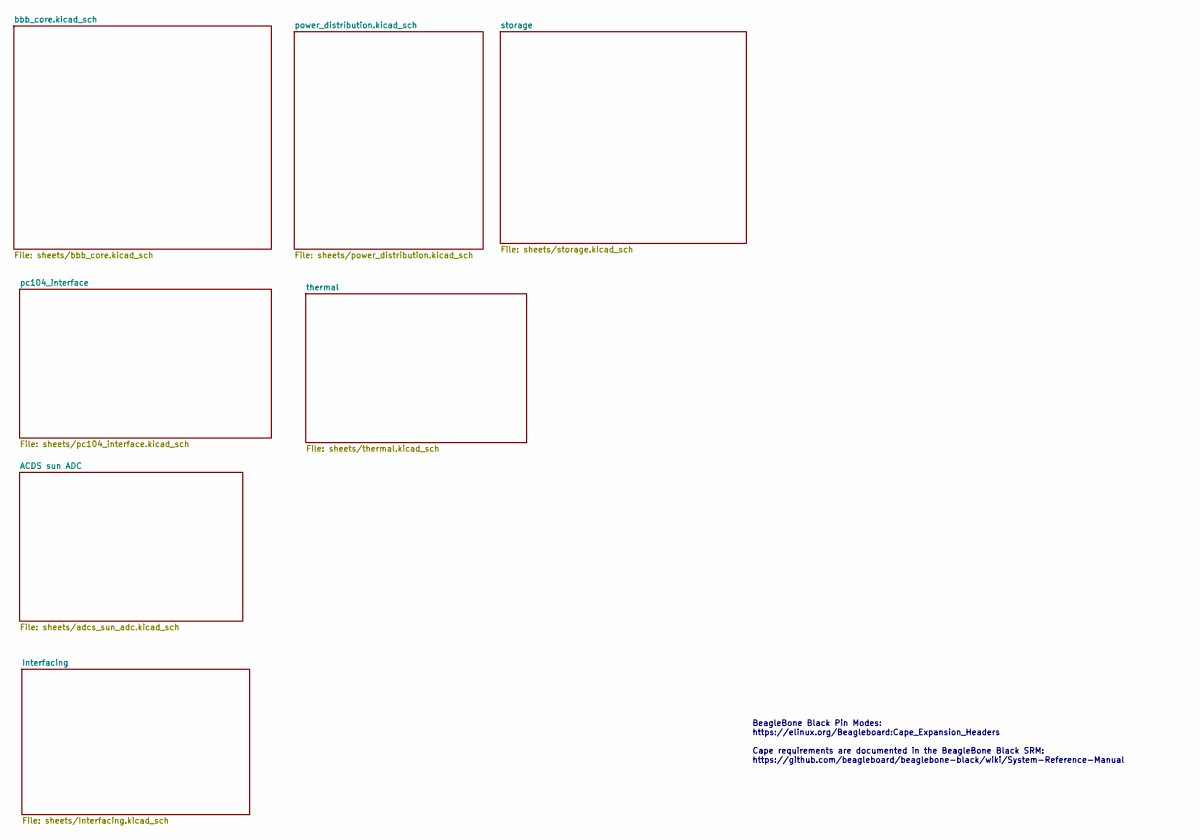
[picture p8: schematic hs2-cdh-pcb.kicad_sch]

Notes on the sheet:
BeagleBone Black Pin Modes: https://elinux.org/Beagleboard:Cape_Expansion_Headers Cape requirements are documented in the BeagleBone Black SRM: https://github.com/beagleboard/beaglebone-black/wiki/System-Reference-Manual
