UWCubeSat/HS2-CDH-PCB/hs2-cdh-pcb.kicad_pcb

## KiCad design hs2-cdh-pcb.kicad_pcb (continued)

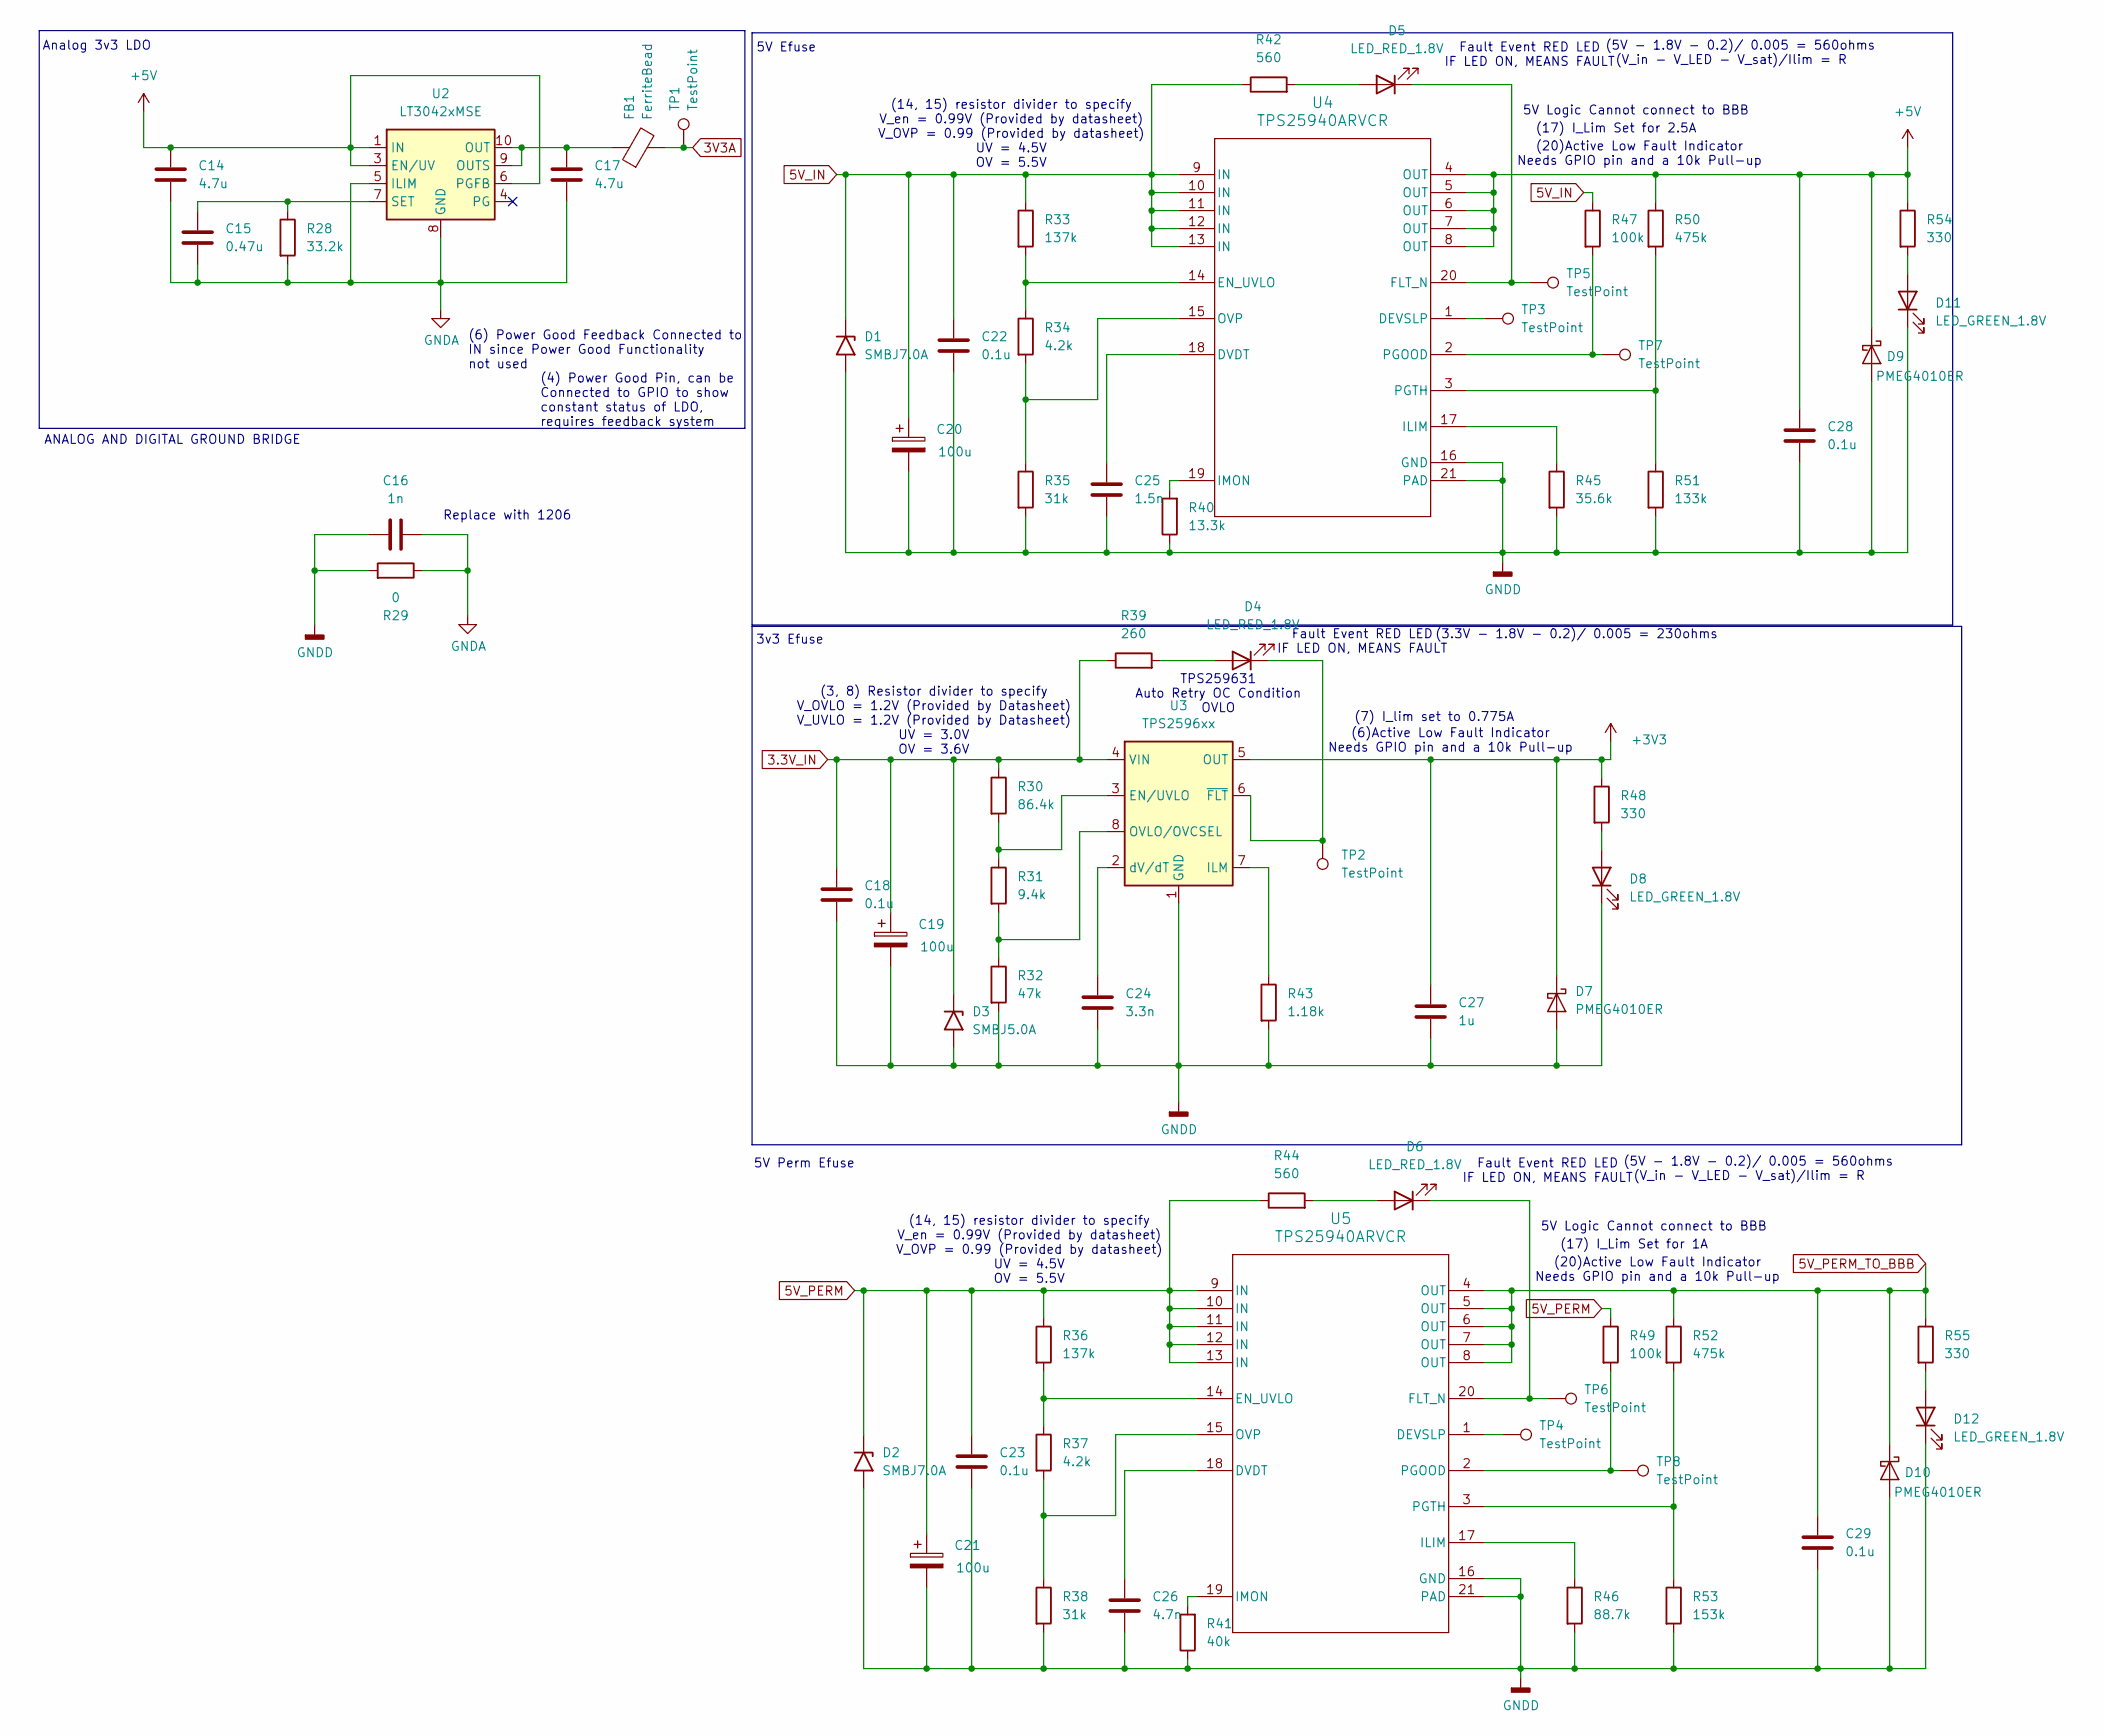
[picture p9: schematic power_distribution.kicad_sch]

Parts:
C14, C17: 4.7u; C_0603_1608Metric
C15: 0.47u; C_0603_1608Metric
C16: 1n; C_1206_3216Metric
C18, C22, C23, C28, C29: 0.1u; C_0603_1608Metric
C19, C20, C21: 100u; CAPMP7.6X4.3_1.9N_KEM
C24: 3.3n; C_0603_1608Metric
C25: 1.5n; C_0603_1608Metric
C26: 4.7n; C_0603_1608Metric
C27: 1u; C_0603_1608Metric
D1, D2: SMBJ7.0A; D_SMA
D3: SMBJ5.0A; D_SMA
D4, D5, D6: LED_RED_1.8V; LED_0603_1608Metric
D7, D9, D10: PMEG4010ER; Nexperia_CFP3_SOD-123W
D8, D11, D12: LED_GREEN_1.8V; LED_0603_1608Metric
FB1: FerriteBead; L_0603_1608Metric
R28: 33.2k; R_0603_1608Metric
R29: 0; R_1206_3216Metric
R30: 86.4k; R_0603_1608Metric
R31: 9.4k; R_0603_1608Metric
R32: 47k; R_0603_1608Metric
R33, R36: 137k; R_0603_1608Metric
R34, R37: 4.2k; R_0603_1608Metric
R35, R38: 31k; R_0603_1608Metric
R39: 260; R_0603_1608Metric
R40: 13.3k; R_0603_1608Metric
R41: 40k; R_0603_1608Metric
R42, R44: 560; R_0603_1608Metric
R43: 1.18k; R_0603_1608Metric
R45: 35.6k; R_0603_1608Metric
R46: 88.7k; R_0603_1608Metric
R47, R49: 100k; R_0603_1608Metric
R48, R54, R55: 330; R_0603_1608Metric
R50, R52: 475k; R_0603_1608Metric
R51: 133k; R_0603_1608Metric
R53: 153k; R_0603_1608Metric
TP1, TP2, TP3, TP4, TP5, TP6, TP7, TP8: TestPoint; TestPoint_Pad_D1.0mm
U2: LT3042xMSE; MSOP-10-1EP_3x3mm_P0.5mm_EP1.68x1.88mm
U3: TPS2596xx; TI_SO-PowerPAD-8_ThermalVias
U4, U5: TPS25940ARVCR; Texas_RVC0020A_WQFN-20-1EP_3x4mm_P0.5mm_EP1.6x2.6mm

Connections:
3.3V_IN: C18.1, C19.1, D3.1 (A1), R30.1, R39.1, U3.4 (VIN); also elsewhere on the board
3V3A: FB1.2, TP1.1 (1_1); also elsewhere on the board
5V_IN: C20.1, C22.1, D1.1 (A1), R33.1, R42.1, R47.1, U4.9 (IN), U4.10 (IN), U4.11 (IN), U4.12 (IN), U4.13 (IN); also elsewhere on the board
5V_PERM: C21.1, C23.1, D2.1 (A1), R36.1, R44.1, R49.1, U5.9 (IN), U5.10 (IN), U5.11 (IN), U5.12 (IN), U5.13 (IN); also elsewhere on the board
5V_PERM_TO_BBB: C29.1, D10.1 (K), R52.1, R55.1, U5.4 (OUT), U5.5 (OUT), U5.6 (OUT), U5.7 (OUT), U5.8 (OUT); also elsewhere on the board
+3V3: C27.1, D7.1 (K), R48.1, U3.5 (OUT); also elsewhere on the board
+5V: C14.1, C28.1, D9.1 (K), R50.1, R54.1, U2.1 (IN), U2.2 (IN), U2.3 (EN/UV), U2.6 (PGFB), U4.4 (OUT), U4.5 (OUT), U4.6 (OUT), U4.7 (OUT), U4.8 (OUT); also elsewhere on the board
GNDA: C14.2, C15.2, C16.2, C17.2, R28.2, R29.1, U2.5 (ILIM), U2.8 (GND), U2.11 (GND); also elsewhere on the board
GNDD: C16.1, C18.2, C19.2, C20.2, C21.2, C22.2, C23.2, C24.2, C25.2, C26.2, C27.2, C28.2, C29.2, D1.2 (A2), D2.2 (A2), D3.2 (A2), D7.2 (A), D8.1 (K), D9.2 (A), D10.2 (A), D11.1 (K), D12.1 (K), R29.2, R32.2, R35.2, R38.2, R40.1, R41.1, R43.2, R45.2, R46.2, R51.2, R53.2, U3.1 (GND), U3.9 (GND), U4.16 (GND), U4.21 (PAD), U5.16 (GND), U5.21 (PAD); also elsewhere on the board
unnamed: D4.2 (A), R39.2
unnamed: D4.1 (K), TP2.1 (1_1), U3.6 (~FLT)
unnamed: D5.2 (A), R42.2
unnamed: D5.1 (K), TP5.1 (1_1), U4.20 (FLT_N)
unnamed: D6.2 (A), R44.2
unnamed: D6.1 (K), TP6.1 (1_1), U5.20 (FLT_N)
unnamed: D8.2 (A), R48.2
unnamed: D11.2 (A), R54.2
unnamed: D12.2 (A), R55.2
unnamed: C17.1, FB1.1, U2.9 (OUTS), U2.10 (OUT)
unnamed: C15.1, R28.1, U2.7 (SET)
unnamed: R30.2, R31.1, U3.3 (EN/UVLO)
unnamed: R43.1, U3.7 (ILM)
unnamed: R31.2, R32.1, U3.8 (OVLO/OVCSEL)
unnamed: C24.1, U3.2 (dV/dT)
unnamed: TP3.1 (1_1), U4.1 (DEVSLP)
unnamed: C25.1, U4.18 (DVDT)
unnamed: R33.2, R34.1, U4.14 (EN_UVLO)
unnamed: R45.1, U4.17 (ILIM)
unnamed: R40.2, U4.19 (IMON)
unnamed: R34.2, R35.1, U4.15 (OVP)
unnamed: R47.2, TP7.1 (1_1), U4.2 (PGOOD)
unnamed: R50.2, R51.1, U4.3 (PGTH)
unnamed: TP4.1 (1_1), U5.1 (DEVSLP)
unnamed: C26.1, U5.18 (DVDT)
unnamed: R36.2, R37.1, U5.14 (EN_UVLO)
unnamed: R46.1, U5.17 (ILIM)
unnamed: R41.2, U5.19 (IMON)
unnamed: R37.2, R38.1, U5.15 (OVP)
unnamed: R49.2, TP8.1 (1_1), U5.2 (PGOOD)
unnamed: R52.2, R53.1, U5.3 (PGTH)

Notes on the sheet:
Fault Event RED LED IF LED ON, MEANS FAULT
(20)Active Low Fault Indicator Needs GPIO pin and a 10k Pull-up
(V_in - V_LED - V_sat)/Ilim = R
(3, 8) Resistor divider to specify V_OVLO = 1.2V (Provided by Datasheet) V_UVLO = 1.2V (Provided by Datasheet) UV = 3.0V OV = 3.6V
(5V - 1.8V - 0.2)/ 0.005 = 560ohms
Replace with 1206
5V Perm Efuse
(4) Power Good Pin, can be Connected to GPIO to show constant status of LDO, requires feedback system
(14, 15) resistor divider to specify V_en = 0.99V (Provided by datasheet) V_OVP = 0.99 (Provided by datasheet) UV = 4.5V OV = 5.5V
ANALOG AND DIGITAL GROUND BRIDGE
(6)Active Low Fault Indicator Needs GPIO pin and a 10k Pull-up
3v3 Efuse
(17) I_Lim Set for 2.5A
5V Logic Cannot connect to BBB
(3.3V - 1.8V - 0.2)/ 0.005 = 230ohms
Analog 3v3 LDO
(7) I_lim set to 0.775A
TPS259631 Auto Retry OC Condition OVLO
5V Efuse
(6) Power Good Feedback Connected to IN since Power Good Functionality not used
(17) I_Lim Set for 1A

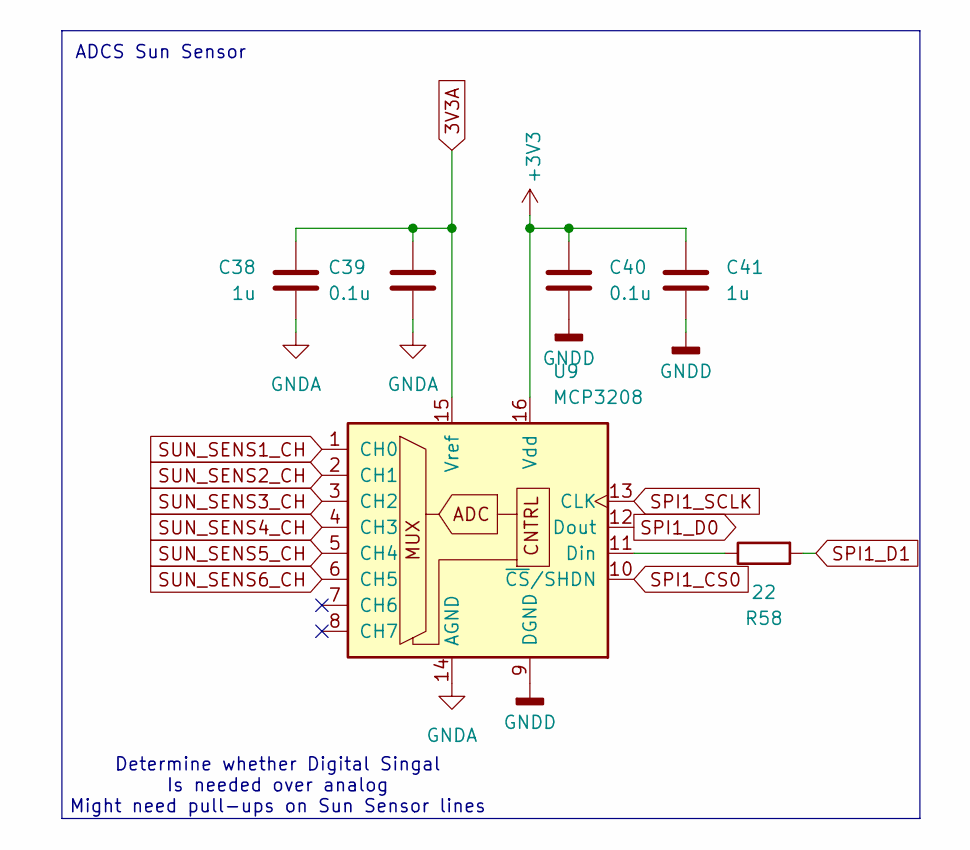
[picture p10: schematic adcs_sun_adc.kicad_sch]

Parts:
C38, C41: 1u; C_0603_1608Metric
C39, C40: 0.1u; C_0603_1608Metric
R58: 22; R_0603_1608Metric
U9: MCP3208; SOIC-16_3.9x9.9mm_P1.27mm

Connections:
3V3A: C38.1, C39.1, U9.15 (Vref); also elsewhere on the board
+3V3: C40.1, C41.1, U9.16 (Vdd); also elsewhere on the board
GNDA: C38.2, C39.2, U9.14 (AGND); also elsewhere on the board
GNDD: C40.2, C41.2, U9.9 (DGND); also elsewhere on the board
unnamed: R58.1, U9.11 (Din)
SPI1_CS0: U9.10 (~CS/SHDN); also elsewhere on the board
SPI1_D0: U9.12 (Dout); also elsewhere on the board
SPI1_D1: R58.2; also elsewhere on the board
SPI1_SCLK: U9.13 (CLK); also elsewhere on the board
SUN_SENS1_CH: U9.1 (CH0); also elsewhere on the board
SUN_SENS2_CH: U9.2 (CH1); also elsewhere on the board
SUN_SENS3_CH: U9.3 (CH2); also elsewhere on the board
SUN_SENS4_CH: U9.4 (CH3); also elsewhere on the board
SUN_SENS5_CH: U9.5 (CH4); also elsewhere on the board
SUN_SENS6_CH: U9.6 (CH5); also elsewhere on the board

Notes on the sheet:
Determine whether Digital Singal Is needed over analog Might need pull-ups on Sun Sensor lines
ADCS Sun Sensor

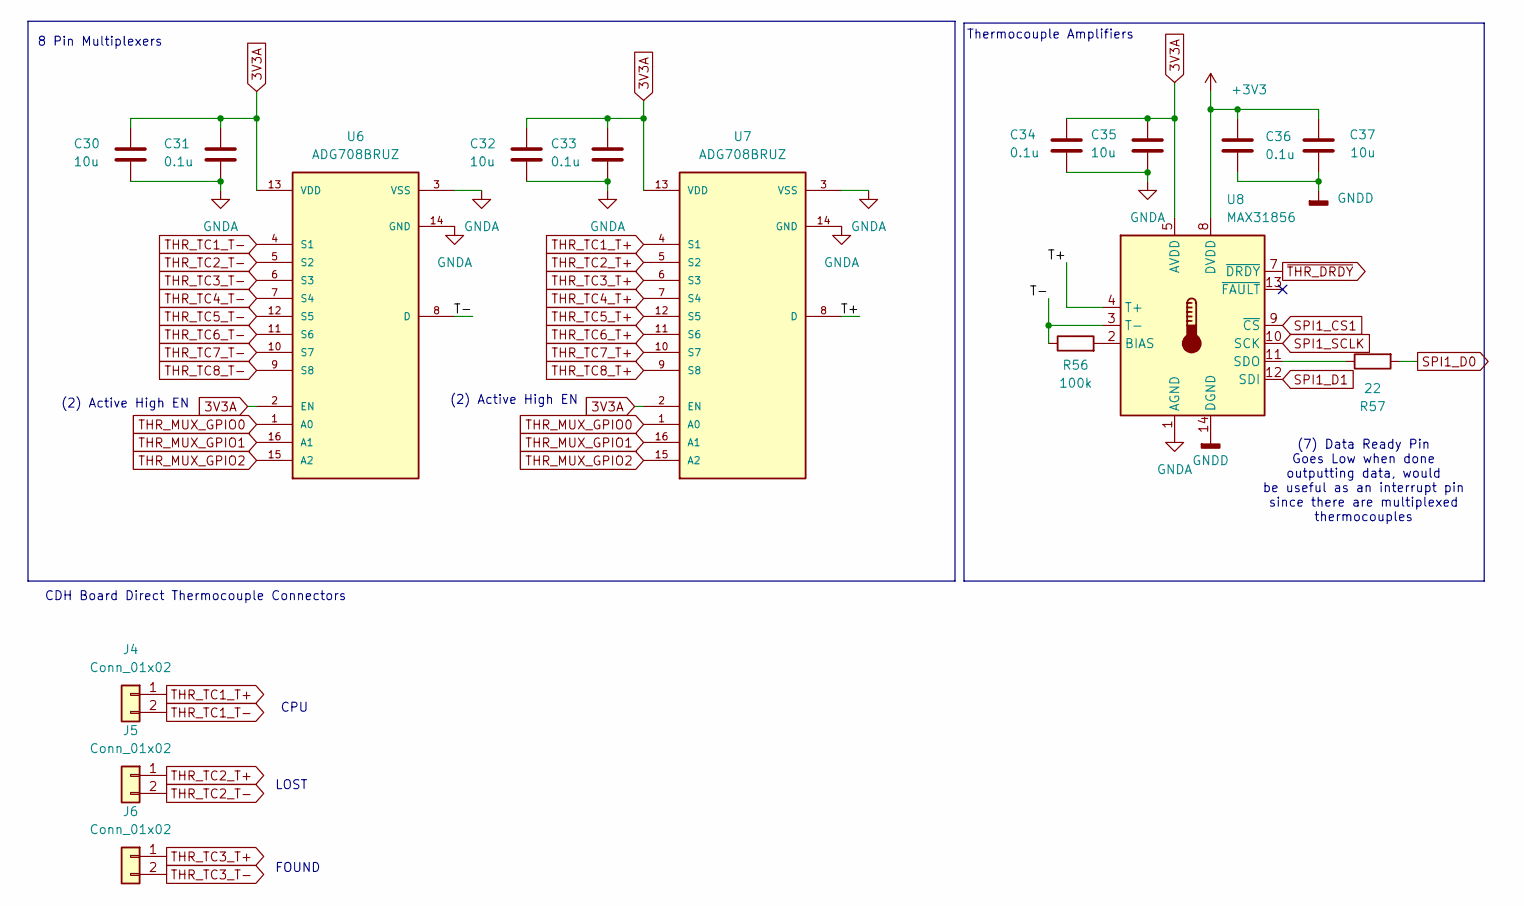
[picture p11: schematic thermal.kicad_sch]

Parts:
C30, C32, C35, C37: 10u; C_0603_1608Metric
C31, C33, C34, C36: 0.1u; C_0603_1608Metric
J4, J5, J6: Conn_01x02; JST_PH_S2B-PH-K_1x02_P2.00mm_Horizontal
R56: 100k; R_0603_1608Metric
R57: 22; R_0603_1608Metric
U6, U7: ADG708BRUZ; TSSOP16
U8: MAX31856; TSSOP-14_4.4x5mm_P0.65mm

Connections:
3V3A: C30.1, C31.1, C32.1, C33.1, C34.1, C35.1, U6.2 (EN), U6.13 (VDD), U7.2 (EN), U7.13 (VDD), U8.5 (AVDD); also elsewhere on the board
+3V3: C36.1, C37.1, U8.8 (DVDD); also elsewhere on the board
/thermal/T+: U7.8 (D), U8.4 (T+)
/thermal/T-: R56.1, U6.8 (D), U8.3 (T-)
GNDA: C30.2, C31.2, C32.2, C33.2, C34.2, C35.2, U6.3 (VSS), U6.14 (GND), U7.3 (VSS), U7.14 (GND), U8.1 (AGND); also elsewhere on the board
GNDD: C36.2, C37.2, U8.14 (DGND); also elsewhere on the board
unnamed: R56.2, U8.2 (BIAS)
unnamed: R57.1, U8.11 (SDO)
SPI1_CS1: U8.9 (~CS); also elsewhere on the board
SPI1_D0: R57.2; also elsewhere on the board
SPI1_D1: U8.12 (SDI); also elsewhere on the board
SPI1_SCLK: U8.10 (SCK); also elsewhere on the board
THR_MUX_GPIO0: U6.1 (A0), U7.1 (A0); also elsewhere on the board
THR_MUX_GPIO1: U6.16 (A1), U7.16 (A1); also elsewhere on the board
THR_MUX_GPIO2: U6.15 (A2), U7.15 (A2); also elsewhere on the board
THR_TC1_T+: J4.1, U7.4 (S1)
THR_TC1_T-: J4.2, U6.4 (S1)
THR_TC2_T+: J5.1, U7.5 (S2)
THR_TC2_T-: J5.2, U6.5 (S2)
THR_TC3_T+: J6.1, U7.6 (S3)
THR_TC3_T-: J6.2, U6.6 (S3)
THR_TC4_T+: U7.7 (S4); also elsewhere on the board
THR_TC4_T-: U6.7 (S4); also elsewhere on the board
THR_TC5_T+: U7.12 (S5); also elsewhere on the board
THR_TC5_T-: U6.12 (S5); also elsewhere on the board
THR_TC6_T+: U7.11 (S6); also elsewhere on the board
THR_TC6_T-: U6.11 (S6); also elsewhere on the board
THR_TC7_T+: U7.10 (S7); also elsewhere on the board
THR_TC7_T-: U6.10 (S7); also elsewhere on the board
THR_TC8_T+: U7.9 (S8); also elsewhere on the board
THR_TC8_T-: U6.9 (S8); also elsewhere on the board
~THR_DRDY: U8.7 (~DRDY); also elsewhere on the board

Notes on the sheet:
LOST
CDH Board Direct Thermocouple Connectors
FOUND
(2) Active High EN
(7) Data Ready Pin Goes Low when done outputting data, would be useful as an interrupt pin since there are multiplexed thermocouples
CPU
8 Pin Multiplexers
Thermocouple Amplifiers

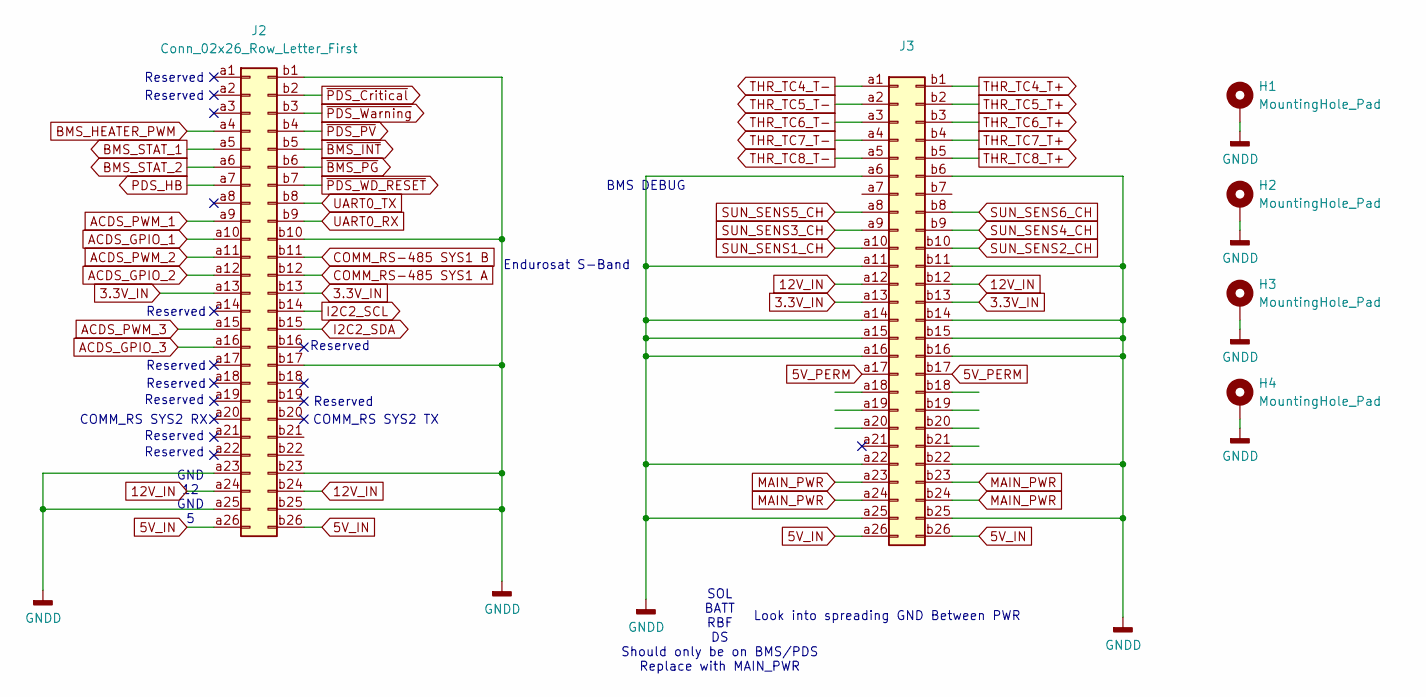
[picture p12: schematic pc104_interface.kicad_sch]

Parts:
H1, H2, H3, H4: MountingHole_Pad; MountingHole_3.2mm_M3_Pad
J2, J3: Conn_02x26_Row_Letter_First; PinSocket_2x26_P2.54mm_Vertical

Connections:
3.3V_IN: J2.a13, J2.b13, J3.a13, J3.b13; also elsewhere on the board
5V_IN: J2.a26, J2.b26, J3.a26, J3.b26; also elsewhere on the board
5V_PERM: J3.a17, J3.b17; also elsewhere on the board
12V_IN: J2.a24, J2.b24, J3.a12, J3.b12
ACDS_GPIO_1: J2.a10; also elsewhere on the board
ACDS_GPIO_2: J2.a12; also elsewhere on the board
ACDS_GPIO_3: J2.a16; also elsewhere on the board
ACDS_PWM_1: J2.a9; also elsewhere on the board
ACDS_PWM_2: J2.a11; also elsewhere on the board
ACDS_PWM_3: J2.a15; also elsewhere on the board
BMS_HEATER_PWM: J2.a4; also elsewhere on the board
BMS_STAT_1: J2.a5; also elsewhere on the board
BMS_STAT_2: J2.a6; also elsewhere on the board
COMM_RS-485 SYS1 A: J2.b12; also elsewhere on the board
COMM_RS-485 SYS1 B: J2.b11; also elsewhere on the board
GNDD: H1.1 (1_1), H2.1 (1_1), H3.1 (1_1), H4.1 (1_1), J2.a23, J2.a25, J2.b1, J2.b10, J2.b17, J2.b23, J2.b25, J3.a6, J3.a11, J3.a14, J3.a15, J3.a16, J3.a22, J3.a25, J3.b6, J3.b11, J3.b14, J3.b15, J3.b16, J3.b22, J3.b25; also elsewhere on the board
I2C2_SCL: J2.b14; also elsewhere on the board
I2C2_SDA: J2.b15; also elsewhere on the board
MAIN_PWR: J3.a23, J3.a24, J3.b23, J3.b24
PDS_HB: J2.a7; also elsewhere on the board
SUN_SENS1_CH: J3.a10; also elsewhere on the board
SUN_SENS2_CH: J3.b10; also elsewhere on the board
SUN_SENS3_CH: J3.a9; also elsewhere on the board
SUN_SENS4_CH: J3.b9; also elsewhere on the board
SUN_SENS5_CH: J3.a8; also elsewhere on the board
SUN_SENS6_CH: J3.b8; also elsewhere on the board
THR_TC4_T+: J3.b1; also elsewhere on the board
THR_TC4_T-: J3.a1; also elsewhere on the board
THR_TC5_T+: J3.b2; also elsewhere on the board
THR_TC5_T-: J3.a2; also elsewhere on the board
THR_TC6_T+: J3.b3; also elsewhere on the board
THR_TC6_T-: J3.a3; also elsewhere on the board
THR_TC7_T+: J3.b4; also elsewhere on the board
THR_TC7_T-: J3.a4; also elsewhere on the board
THR_TC8_T+: J3.b5; also elsewhere on the board
THR_TC8_T-: J3.a5; also elsewhere on the board
UART0_RX: J2.b9; also elsewhere on the board
UART0_TX: J2.b8; also elsewhere on the board
~BMS_INT: J2.b5; also elsewhere on the board
~BMS_PG: J2.b6; also elsewhere on the board
~PDS_Critical: J2.b2; also elsewhere on the board
~PDS_PV: J2.b4; also elsewhere on the board
~PDS_WD_RESET: J2.b7; also elsewhere on the board
~PDS_Warning: J2.b3; also elsewhere on the board

Notes on the sheet:
Reserved
COMM_RS SYS2 RX
SOL BATT RBF DS Should only be on BMS/PDS Replace with MAIN_PWR
Endurosat S-Band
GND 12 GND 5
Look into spreading GND Between PWR
COMM_RS SYS2 TX
BMS DEBUG

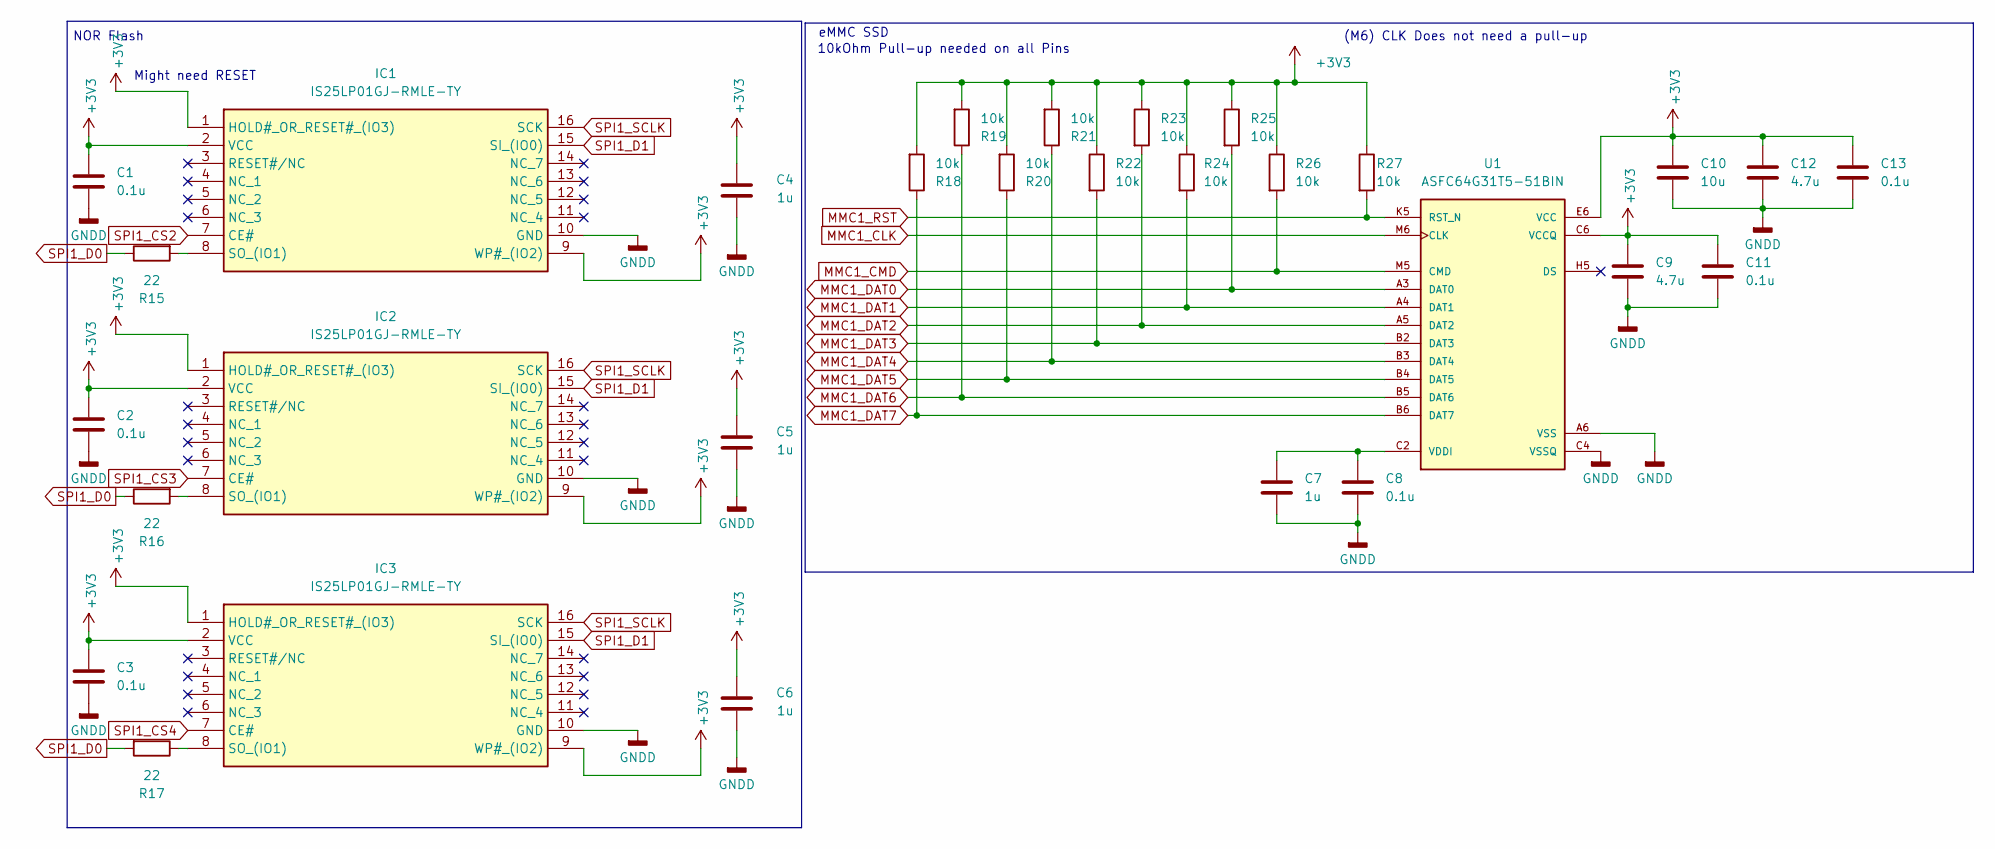
[picture p13: schematic storage.kicad_sch]

Parts:
C1, C2, C3, C8, C11, C13: 0.1u; C_0603_1608Metric
C4, C5, C6, C7: 1u; C_0603_1608Metric
C9, C12: 4.7u; C_0603_1608Metric
C10: 10u; C_0603_1608Metric
IC1, IC2, IC3: IS25LP01GJ-RMLE-TY; SOIC127P1032X265-16N; Manufacturer_Part_Number IS25LP01GJ-RMLE-TY
R15, R16, R17: 22; R_0603_1608Metric
R18, R19, R20, R21, R22, R23, R24, R25, R26, R27: 10k; R_0603_1608Metric
U1: ASFC64G31T5-51BIN; LFBGA-153_11.5x13mm_Layout14x14_P0.5mm

Connections:
+3V3: C1.1, C2.1, C3.1, C4.1, C5.1, C6.1, C9.1, C10.1, C11.1, C12.1, C13.1, IC1.1 (HOLD#_OR_RESET#_(IO3)), IC1.2 (VCC), IC1.9 (WP#_(IO2)), IC2.1 (HOLD#_OR_RESET#_(IO3)), IC2.2 (VCC), IC2.9 (WP#_(IO2)), IC3.1 (HOLD#_OR_RESET#_(IO3)), IC3.2 (VCC), IC3.9 (WP#_(IO2)), R18.2, R19.2, R20.2, R21.2, R22.1, R23.1, R24.1, R25.1, R26.1, R27.1, U1.C6 (VCCQ), U1.E6 (VCC), U1.F5 (VCC), U1.J10 (VCC), U1.K9 (VCC), U1.M4 (VCCQ), U1.N4 (VCCQ), U1.P3 (VCCQ), U1.P5 (VCCQ); also elsewhere on the board
GNDD: C1.2, C2.2, C3.2, C4.2, C5.2, C6.2, C7.2, C8.2, C9.2, C10.2, C11.2, C12.2, C13.2, IC1.10 (GND), IC2.10 (GND), IC3.10 (GND), U1.A6 (VSS), U1.C4 (VSSQ), U1.E7 (VSS), U1.G5 (VSS), U1.H10 (VSS), U1.J5 (VSS), U1.K8 (VSS), U1.N2 (VSSQ), U1.N5 (VSSQ), U1.P4 (VSSQ), U1.P6 (VSSQ); also elsewhere on the board
MMC1_CLK: U1.M6 (CLK); also elsewhere on the board
MMC1_CMD: R26.2, U1.M5 (CMD); also elsewhere on the board
MMC1_DAT0: R25.2, U1.A3 (DAT0); also elsewhere on the board
MMC1_DAT1: R24.2, U1.A4 (DAT1); also elsewhere on the board
MMC1_DAT2: R23.2, U1.A5 (DAT2); also elsewhere on the board
MMC1_DAT3: R22.2, U1.B2 (DAT3); also elsewhere on the board
MMC1_DAT4: R21.1, U1.B3 (DAT4); also elsewhere on the board
MMC1_DAT5: R20.1, U1.B4 (DAT5); also elsewhere on the board
MMC1_DAT6: R19.1, U1.B5 (DAT6); also elsewhere on the board
MMC1_DAT7: R18.1, U1.B6 (DAT7); also elsewhere on the board
MMC1_RST: R27.2, U1.K5 (RST_N); also elsewhere on the board
unnamed: IC1.8 (SO_(IO1)), R15.2
unnamed: IC2.8 (SO_(IO1)), R16.2
unnamed: IC3.8 (SO_(IO1)), R17.1
unnamed: C7.1, C8.1, U1.C2 (VDDI)
SPI1_CS2: IC1.7 (CE#); also elsewhere on the board
SPI1_CS3: IC2.7 (CE#); also elsewhere on the board
SPI1_CS4: IC3.7 (CE#); also elsewhere on the board
SPI1_D0: R15.1, R16.1, R17.2; also elsewhere on the board
SPI1_D1: IC1.15 (SI_(IO0)), IC2.15 (SI_(IO0)), IC3.15 (SI_(IO0)); also elsewhere on the board
SPI1_SCLK: IC1.16 (SCK), IC2.16 (SCK), IC3.16 (SCK); also elsewhere on the board

Notes on the sheet:
(M6) CLK Does not need a pull-up
Might need RESET
eMMC SSD
10kOhm Pull-up needed on all Pins
NOR Flash

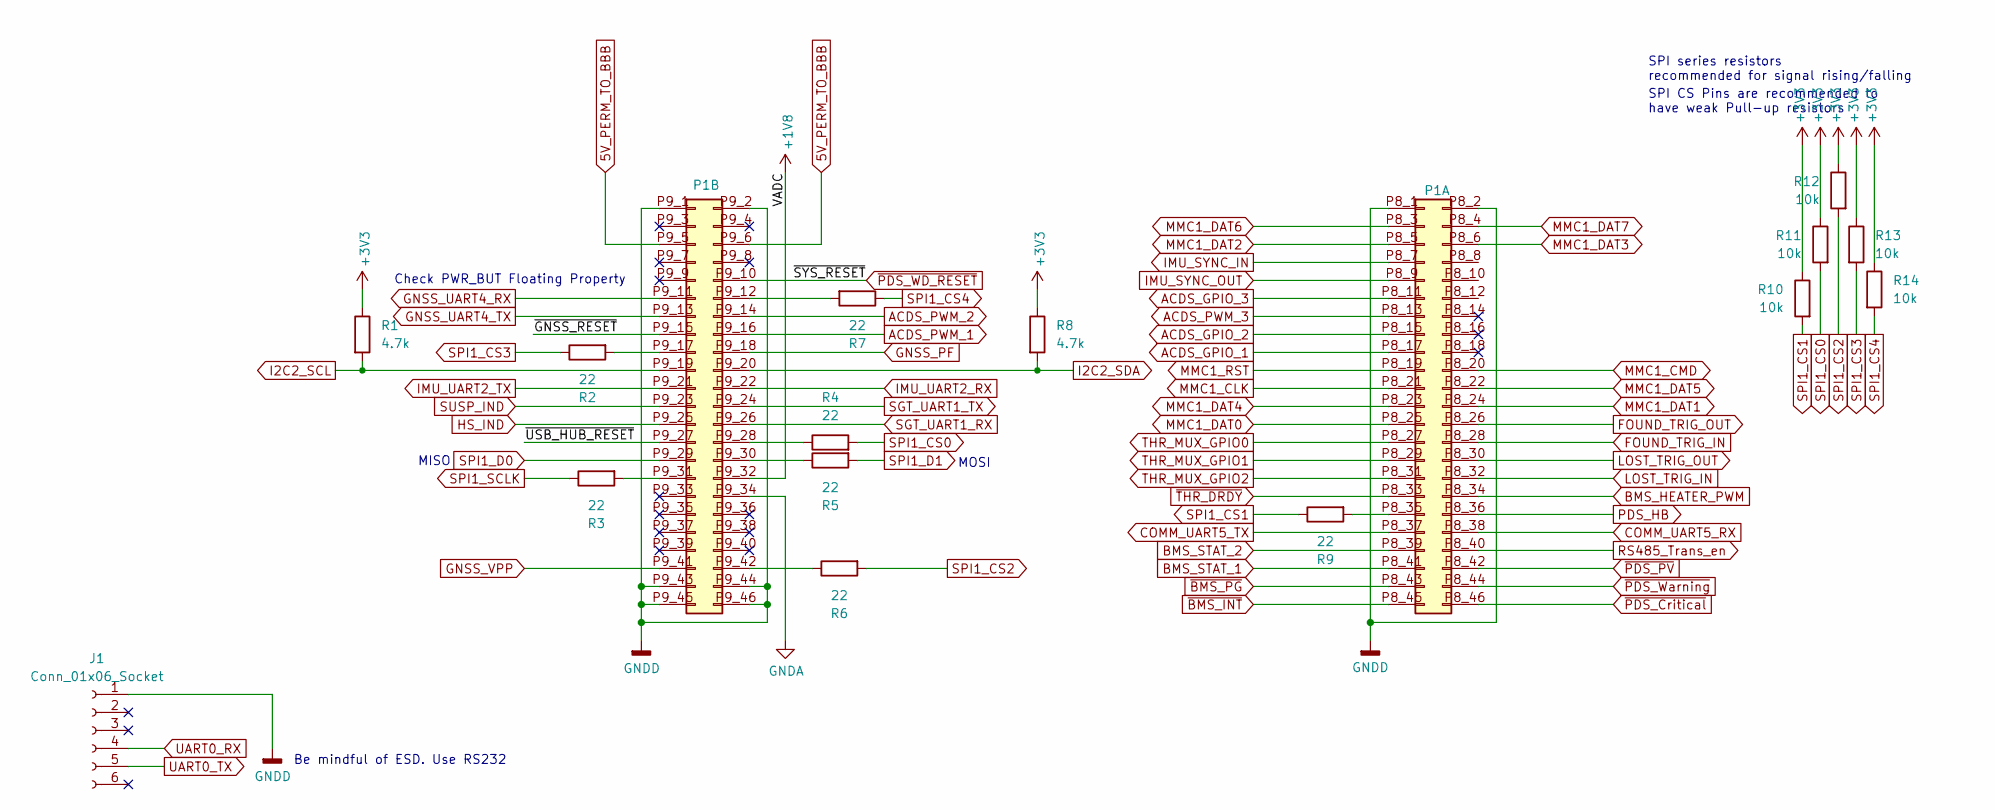
[picture p14: schematic bbb_core.kicad_sch]

Parts:
J1: Conn_01x06_Socket; PinSocket_1x06_P2.54mm_Vertical
P1: BBB_Cape
R1, R8: 4.7k; R_0603_1608Metric
R2, R3, R4, R5, R6, R7, R9: 22; R_0603_1608Metric
R10, R11, R12, R13, R14: 10k; R_0603_1608Metric

Connections:
5V_PERM_TO_BBB: P1.P9_5 (Pin_5), P1.P9_6 (Pin_6); also elsewhere on the board
+1V8: P1.P9_32 (Pin_32)
+3V3: R1.1, R8.1, R10.1, R11.1, R12.1, R13.1, R14.1; also elsewhere on the board
/bbb_core.kicad_sch/~GNSS_RESET: P1.P9_15 (Pin_15)
/bbb_core.kicad_sch/~USB_HUB_RESET: P1.P9_27 (Pin_27)
ACDS_GPIO_1: P1.P8_17 (Pin_17); also elsewhere on the board
ACDS_GPIO_2: P1.P8_15 (Pin_15); also elsewhere on the board
ACDS_GPIO_3: P1.P8_11 (Pin_11); also elsewhere on the board
ACDS_PWM_1: P1.P9_16 (Pin_16); also elsewhere on the board
ACDS_PWM_2: P1.P9_14 (Pin_14); also elsewhere on the board
ACDS_PWM_3: P1.P8_13 (Pin_13); also elsewhere on the board
BMS_HEATER_PWM: P1.P8_34 (Pin_34); also elsewhere on the board
BMS_STAT_1: P1.P8_41 (Pin_41); also elsewhere on the board
BMS_STAT_2: P1.P8_39 (Pin_39); also elsewhere on the board
COMM_UART5_RX: P1.P8_38 (Pin_38); also elsewhere on the board
COMM_UART5_TX: P1.P8_37 (Pin_37); also elsewhere on the board
FOUND_TRIG_IN: P1.P8_28 (Pin_28); also elsewhere on the board
FOUND_TRIG_OUT: P1.P8_26 (Pin_26); also elsewhere on the board
GNDA: P1.P9_34 (Pin_34); also elsewhere on the board
GNDD: J1.1, P1.P8_1 (Pin_1), P1.P8_2 (Pin_2), P1.P9_1 (Pin_1), P1.P9_2 (Pin_2), P1.P9_43 (Pin_43), P1.P9_44 (Pin_44), P1.P9_45 (Pin_45), P1.P9_46 (Pin_46); also elsewhere on the board
GNSS_PF: P1.P9_18 (Pin_18); also elsewhere on the board
GNSS_UART4_RX: P1.P9_11 (Pin_11); also elsewhere on the board
GNSS_UART4_TX: P1.P9_13 (Pin_13); also elsewhere on the board
GNSS_VPP: P1.P9_41 (Pin_41); also elsewhere on the board
HS_IND: P1.P9_25 (Pin_25); also elsewhere on the board
I2C2_SCL: P1.P9_19 (Pin_19), R1.2; also elsewhere on the board
I2C2_SDA: P1.P9_20 (Pin_20), R8.2; also elsewhere on the board
IMU_SYNC_IN: P1.P8_7 (Pin_7); also elsewhere on the board
IMU_SYNC_OUT: P1.P8_9 (Pin_9); also elsewhere on the board
IMU_UART2_RX: P1.P9_22 (Pin_22); also elsewhere on the board
IMU_UART2_TX: P1.P9_21 (Pin_21); also elsewhere on the board
LOST_TRIG_IN: P1.P8_32 (Pin_32); also elsewhere on the board
LOST_TRIG_OUT: P1.P8_30 (Pin_30); also elsewhere on the board
MMC1_CLK: P1.P8_21 (Pin_21); also elsewhere on the board
MMC1_CMD: P1.P8_20 (Pin_20); also elsewhere on the board
MMC1_DAT0: P1.P8_25 (Pin_25); also elsewhere on the board
MMC1_DAT1: P1.P8_24 (Pin_24); also elsewhere on the board
MMC1_DAT2: P1.P8_5 (Pin_5); also elsewhere on the board
MMC1_DAT3: P1.P8_6 (Pin_6); also elsewhere on the board
MMC1_DAT4: P1.P8_23 (Pin_23); also elsewhere on the board
MMC1_DAT5: P1.P8_22 (Pin_22); also elsewhere on the board
MMC1_DAT6: P1.P8_3 (Pin_3); also elsewhere on the board
MMC1_DAT7: P1.P8_4 (Pin_4); also elsewhere on the board
MMC1_RST: P1.P8_19 (Pin_19); also elsewhere on the board
unnamed: P1.P8_35 (Pin_35), R9.2
unnamed: P1.P9_12 (Pin_12), R7.2
unnamed: P1.P9_17 (Pin_17), R2.2
unnamed: P1.P9_28 (Pin_28), R4.1
unnamed: P1.P9_30 (Pin_30), R5.1
unnamed: P1.P9_31 (Pin_31), R3.2
unnamed: P1.P9_42 (Pin_42), R6.1
PDS_HB: P1.P8_36 (Pin_36); also elsewhere on the board
RS485_Trans_en: P1.P8_40 (Pin_40); also elsewhere on the board
SGT_UART1_RX: P1.P9_26 (Pin_26); also elsewhere on the board
SGT_UART1_TX: P1.P9_24 (Pin_24); also elsewhere on the board
SPI1_CS0: R4.2, R11.2; also elsewhere on the board
SPI1_CS1: R9.1, R10.2; also elsewhere on the board
SPI1_CS2: R6.2, R12.2; also elsewhere on the board
SPI1_CS3: R2.1, R13.2; also elsewhere on the board
SPI1_CS4: R7.1, R14.2; also elsewhere on the board
SPI1_D0: P1.P9_29 (Pin_29); also elsewhere on the board
SPI1_D1: R5.2; also elsewhere on the board
SPI1_SCLK: R3.1; also elsewhere on the board
SUSP_IND: P1.P9_23 (Pin_23); also elsewhere on the board
THR_MUX_GPIO0: P1.P8_27 (Pin_27); also elsewhere on the board
THR_MUX_GPIO1: P1.P8_29 (Pin_29); also elsewhere on the board
THR_MUX_GPIO2: P1.P8_31 (Pin_31); also elsewhere on the board
UART0_RX: J1.4; also elsewhere on the board
UART0_TX: J1.5; also elsewhere on the board
~BMS_INT: P1.P8_45 (Pin_45); also elsewhere on the board
~BMS_PG: P1.P8_43 (Pin_43); also elsewhere on the board
~PDS_Critical: P1.P8_46 (Pin_46); also elsewhere on the board
~PDS_PV: P1.P8_42 (Pin_42); also elsewhere on the board
~PDS_WD_RESET: P1.P9_10 (Pin_10); also elsewhere on the board
~PDS_Warning: P1.P8_44 (Pin_44); also elsewhere on the board
~THR_DRDY: P1.P8_33 (Pin_33); also elsewhere on the board

Notes on the sheet:
MISO
SPI CS Pins are recommended to have weak Pull-up resistors
Be mindful of ESD. Use RS232
Check PWR_BUT Floating Property
SPI series resistors recommended for signal rising/falling
MOSI
