UWCubeSat/HS2-CDH-PCB/hs2-cdh-pcb.kicad_pcb

## KiCad design hs2-cdh-pcb.kicad_pcb (continued)

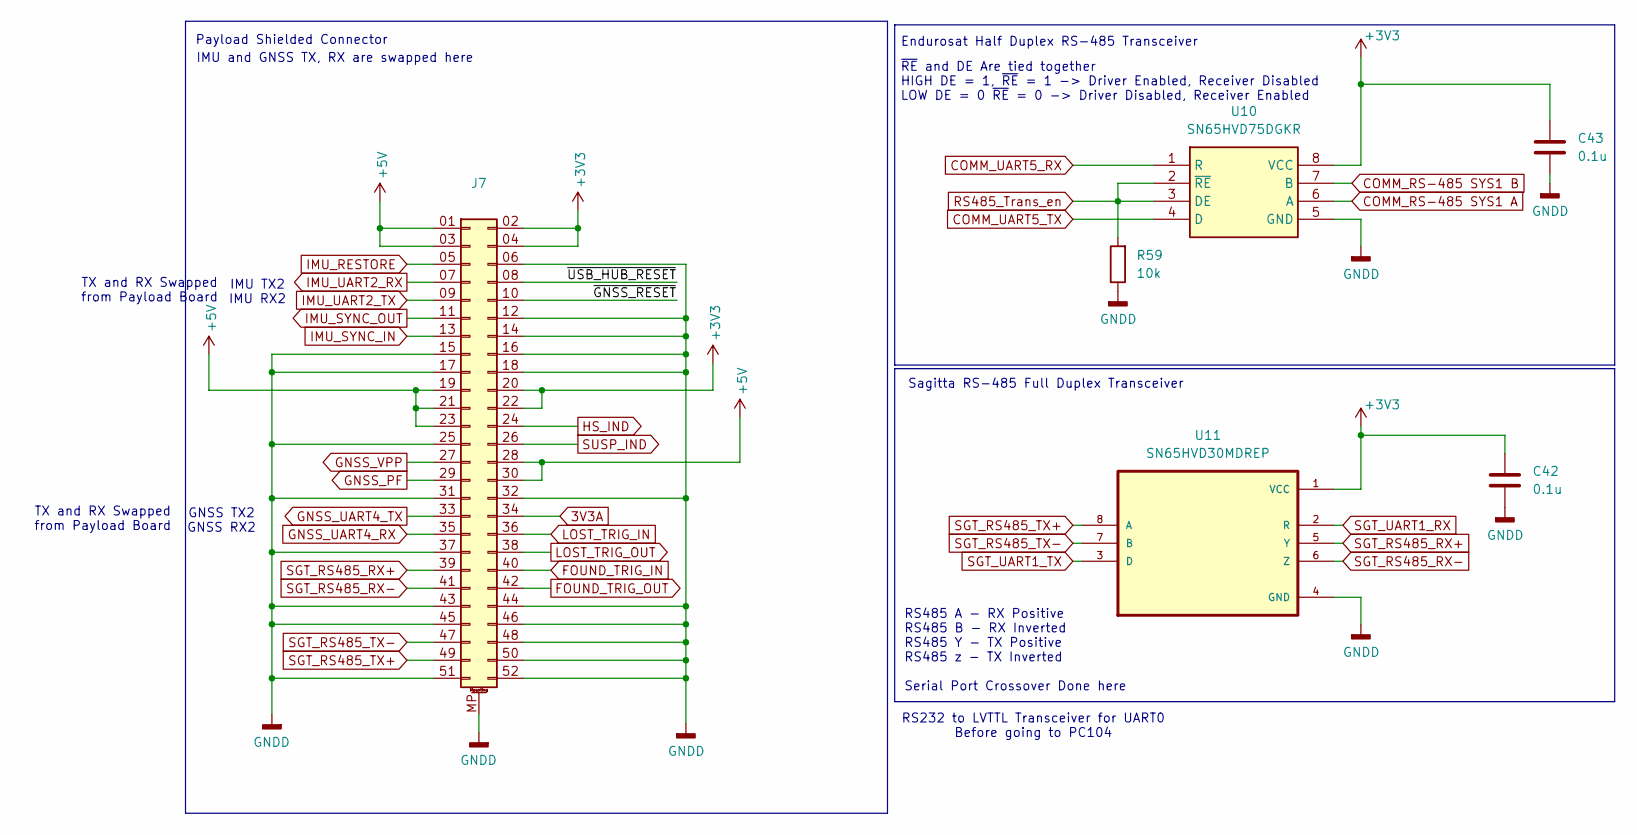
[picture p15: schematic Interfacing.kicad_sch]

Parts:
C42, C43: 0.1u; C_0603_1608Metric
J7: Conn_02x26_Odd_Even_MountingPin; SAMTEC_ASP-129637
R59: 10k; R_0603_1608Metric
U10: SN65HVD75DGKR; VSSOP-8_3x3mm_P0.65mm; Mouser Part Number 595-SN65HVD75DGKR
U11: SN65HVD30MDREP; SOIC-8_3.9x4.9mm_P1.27mm

Connections:
3V3A: J7.34; also elsewhere on the board
+3V3: C42.1, C43.1, J7.02 (Pin_2), J7.04 (Pin_4), J7.20, J7.22, U10.8 (VCC), U11.1 (VCC); also elsewhere on the board
+5V: J7.01 (Pin_1), J7.03 (Pin_3), J7.19, J7.21, J7.23, J7.28, J7.30; also elsewhere on the board
/Interfacing/~GNSS_RESET: J7.10
/Interfacing/~USB_HUB_RESET: J7.08 (Pin_8)
COMM_RS-485 SYS1 A: U10.6 (A); also elsewhere on the board
COMM_RS-485 SYS1 B: U10.7 (B); also elsewhere on the board
COMM_UART5_RX: U10.1 (R); also elsewhere on the board
COMM_UART5_TX: U10.4 (D); also elsewhere on the board
FOUND_TRIG_IN: J7.40; also elsewhere on the board
FOUND_TRIG_OUT: J7.42; also elsewhere on the board
GNDD: C42.2, C43.2, J7.06 (Pin_6), J7.12, J7.14, J7.15, J7.16, J7.17, J7.18, J7.25, J7.31, J7.32, J7.37, J7.43, J7.44, J7.45, J7.46, J7.48, J7.50, J7.51, J7.52, J7.MP (MountPin), R59.1, U10.5 (GND), U11.4 (GND); also elsewhere on the board
GNSS_PF: J7.29; also elsewhere on the board
GNSS_UART4_RX: J7.35; also elsewhere on the board
GNSS_UART4_TX: J7.33; also elsewhere on the board
GNSS_VPP: J7.27; also elsewhere on the board
HS_IND: J7.24; also elsewhere on the board
IMU_RESTORE: J7.05 (Pin_5)
IMU_SYNC_IN: J7.13; also elsewhere on the board
IMU_SYNC_OUT: J7.11; also elsewhere on the board
IMU_UART2_RX: J7.07 (Pin_7); also elsewhere on the board
IMU_UART2_TX: J7.09 (Pin_9); also elsewhere on the board
LOST_TRIG_IN: J7.36; also elsewhere on the board
LOST_TRIG_OUT: J7.38; also elsewhere on the board
RS485_Trans_en: R59.2, U10.2 (~RE), U10.3 (DE); also elsewhere on the board
SGT_RS485_RX+: J7.39, U11.5 (Y)
SGT_RS485_RX-: J7.41, U11.6 (Z)
SGT_RS485_TX+: J7.49, U11.8 (A)
SGT_RS485_TX-: J7.47, U11.7 (B)
SGT_UART1_RX: U11.2 (R); also elsewhere on the board
SGT_UART1_TX: U11.3 (D); also elsewhere on the board
SUSP_IND: J7.26; also elsewhere on the board

Notes on the sheet:
Sagitta RS-485 Full Duplex Transceiver
Payload Shielded Connector
IMU TX2 IMU RX2
GNSS TX2 GNSS RX2
TX and RX Swapped from Payload Board
~{RE} and DE Are tied together HIGH DE = 1, ~{RE} = 1 -> Driver Enabled, Receiver Disabled LOW DE = 0 ~{RE} = 0 -> Driver Disabled, Receiver Enabled
Endurosat Half Duplex RS-485 Transceiver
RS232 to LVTTL Transceiver for UART0 Before going to PC104
RS485 A - RX Positive RS485 B - RX Inverted RS485 Y - TX Positive RS485 z - TX Inverted Serial Port Crossover Done here
IMU and GNSS TX, RX are swapped here

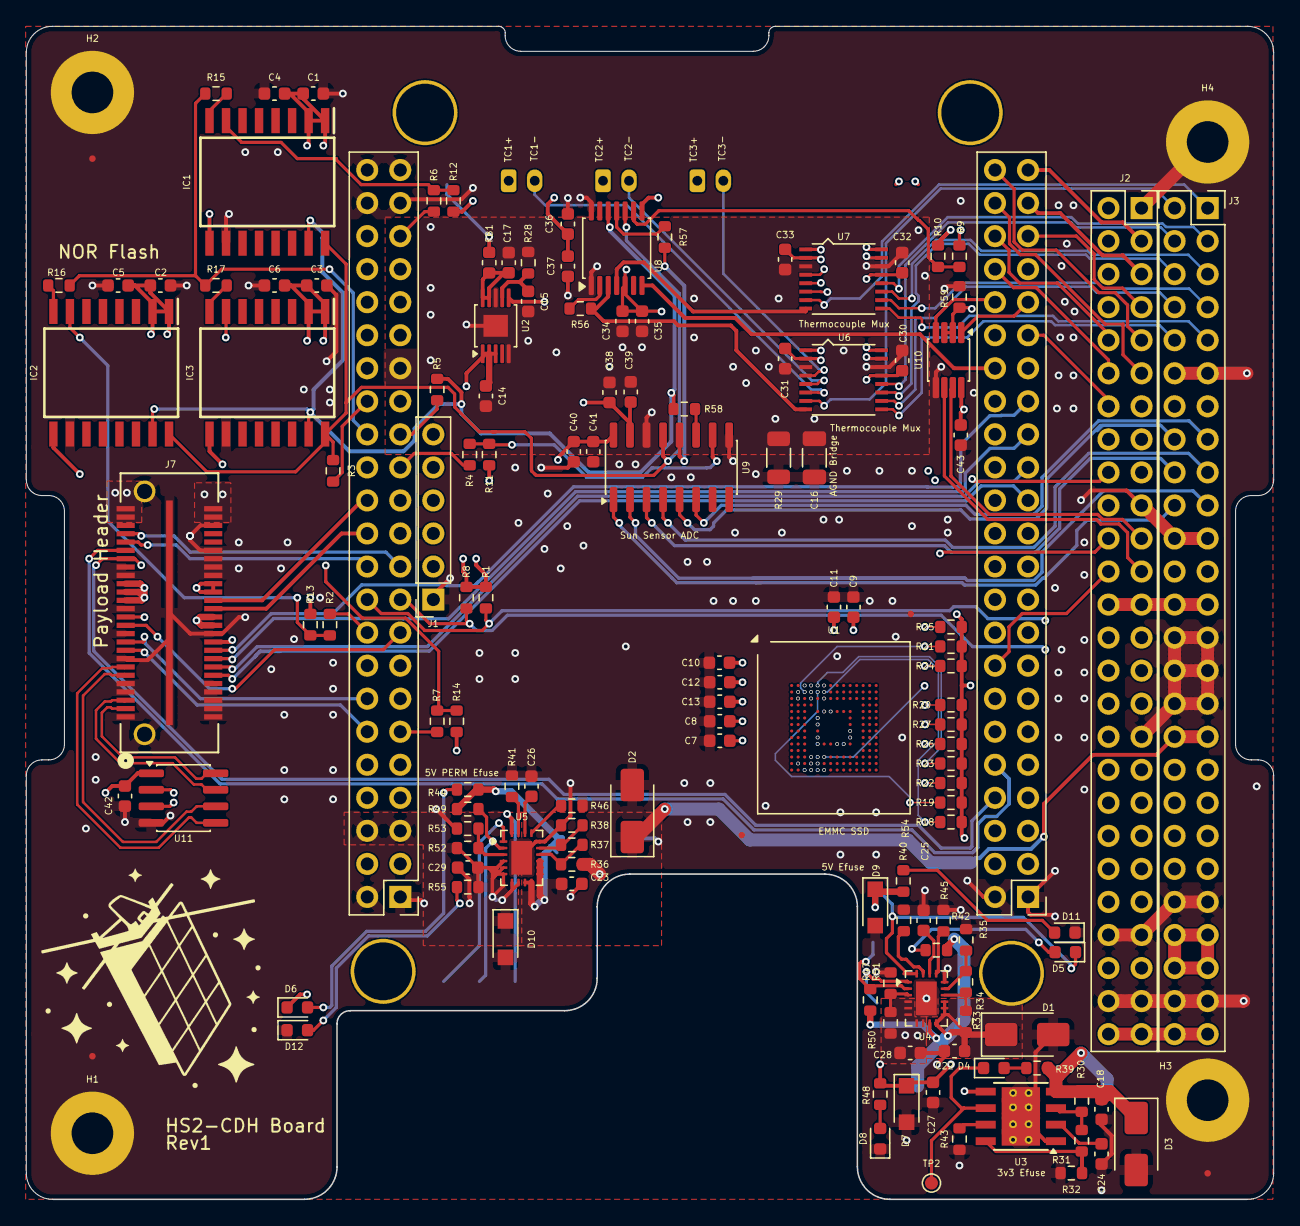
[picture p16: board hs2-cdh-pcb.kicad_pcb from above]

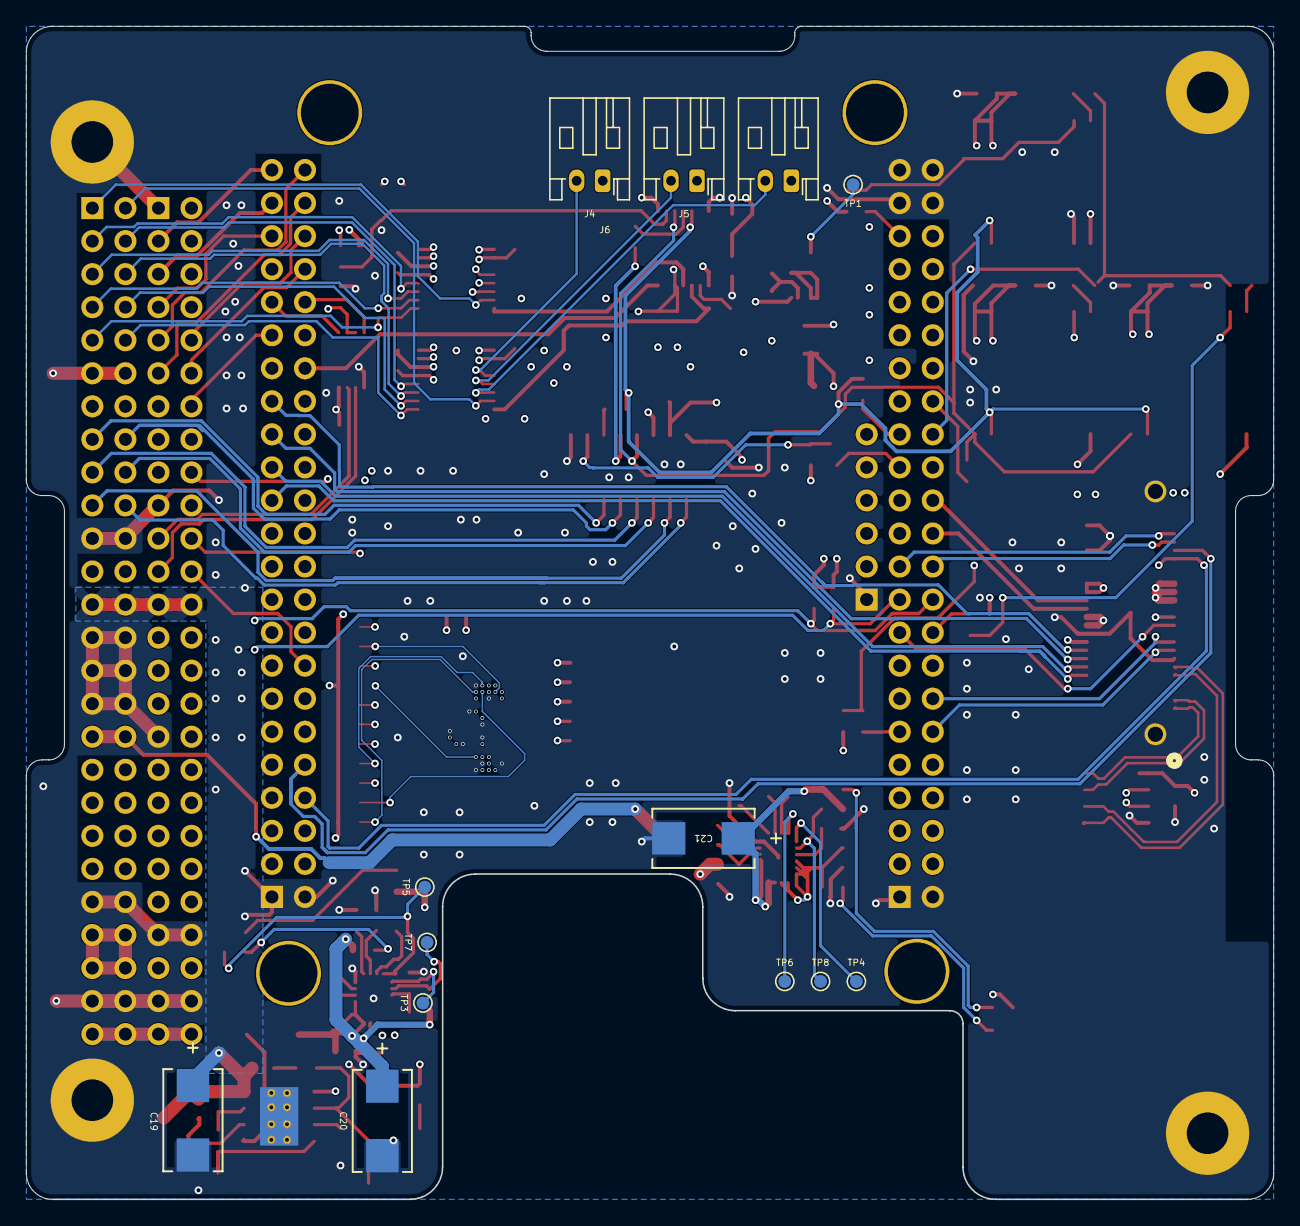
[picture p17: board hs2-cdh-pcb.kicad_pcb from below]

Board: 6 copper layers, 95.9 x 90.2 mm, 149 parts (13 on the bottom side), 148 nets.
