UWCubeSat/HS2-CDH-PCB/(commit log)

2026-05-20 initial commit with bbb template kicad project
    [bbb-cape-template.kicad_pcb, bbb-cape-template.kicad_sch]
2026-05-20 updated to kicad 10
    [bbb-cape-template.kicad_pcb]
2026-05-20 added memory chips schematic into library
2026-05-20 added nor memory symbols
    [bbb-cape-template.kicad_sch]
2026-05-25 Initial KiCad project structure and gitignore configuration
    [bbb-cape-template.kicad_sch, bbb_core.kicad_sch, hs2-cdh-pcb.kicad_pcb, hs2-cdh-pcb.kicad_sch, nor_flash.kicad_sch, pc104_interface.kicad_sch]
2026-05-26 Adding BBB cape and NOR flash ICs
    [bbb_core.kicad_sch, nor_flash.kicad_sch]
2026-05-26 Pushing changes to top level after removing bbb cape and nor flash ics
    [hs2-cdh-pcb.kicad_sch]
2026-05-26 pulled PC104 from EPS board
2026-05-26 Adding power distribution schematic
    [hs2-cdh-pcb.kicad_sch, power_distribution.kicad_sch]
2026-05-29 power distrubtion schematic, exact components tbd
    [power_distribution.kicad_sch]
2026-05-30 oops forgot to add all changes from prev commits
    [hs2-cdh-pcb.kicad_sch, thermal.kicad_sch]
2026-07-04 adding NC (no errors on ERC)
    [nor_flash.kicad_sch]
2026-07-15 pushing storage
    [adcs_sun_adc.kicad_sch, bbb_core.kicad_sch, hs2-cdh-pcb.kicad_sch, nor_flash.kicad_sch, storage.kicad_sch, thermal.kicad_sch]
2026-07-15 adding pc104 from EPS
    [hs2-cdh-pcb.kicad_sch, pc104_interface.kicad_sch]
2026-07-15 allocating pins ?
    [adcs_sun_adc.kicad_sch, bbb_core.kicad_sch, pc104_interface.kicad_sch, thermal.kicad_sch]
2026-07-15 uart global labels (not mapped onto pc104 yet)
    [bbb_core.kicad_sch]
2026-07-15 one more uart (I think it is needed)
    [bbb_core.kicad_sch]
2026-07-15 ferrite bead
    [adcs_sun_adc.kicad_sch, thermal.kicad_sch]
2026-07-15 removing F from capacitors
    [adcs_sun_adc.kicad_sch, storage.kicad_sch, thermal.kicad_sch]
2026-07-27 Payload PCB folder added
    Payload PCB separated into its own KiCAD Project File. BOM created
2026-08-01 typo on mmc pin
2026-08-03 Payload PCB routed
2026-08-21 Payload PCB for Review
2026-08-27 Pushed CDH PCB rev1
    Literally almost lost all of these files
2026-08-28 CDH and PAY PCB BOMs created and ready for Order
    REV1
2026-11-04 removed eUSB from payload board schematic
2026-11-04 added connector 3d models
2026-11-05 fixed Y1 footprint issue
2026-11-06 final IMU changes + misc. bug fixes
2026-11-11 samtec connector flip, added debug connectors, misc. fixes
2026-11-11 switched to 0603 resistors
2026-11-13 changed trace widths for impedance matched traces
